cyx3705/2025-001/b-Office/电气BOM表.xlsx

Sheet: Revision History
Revision 版本 | Description 变更描述 | Date 变更日期 | Updated BY 变更人 | Remarks 备注
1.01 | 新增伺服驱动器外部电气元件表格17-23栏,文档号修改 | 2025-11-20 | 夏姜楠
1.02 | 减少断路器、滤波器、制动电阻、保险丝个数 | 2025-11-21 | 夏姜楠
1.03 | 新增1个数字输出模块和9个端子排 | 2025-11-21 | 夏姜楠

Sheet: BOM模板
 | Product Name 成品名称 |  | DOC. Number 文件编号 |  | Rev. 版本号 |  |  | Updated BY 更新人 |  | Checked BY 审核人 |  | Approved BY 批准人
 |  |  | BOM-503TWM0203 |  | 1.03 |  |  |  |  |  |  |  |  |  | T
 |  |  |  |  |  |  |  | Date 日期 |  | Date 日期 |  | Date 日期
 |  |  | Initial Date 初版日期
Item 序号 | 文档号 | Description 名称 | Specification 参数描述 | Manufacturer 制造商 |  | RoHS 有毒 元素 控制 | QTY 数量 | Unit 单位 | Substitute P/N 替代料P/N | Remarks 备注 | EPDM Auto EPDM自动导出 | Optimized 优选等级 | Unit Price 单价(RMB) | Subtotal 合计(RMB)
 |  |  |  | Model No. 型号 | Brand 品牌
1 | N2511-030Q | 小型断路器 | 220v / 6A | NXB-63H | CHT |  | 1 | 个
2 | N2511-0306 | 变压器 | 220V AC/24V DC | NDKH-40 | CHT |  | 1 | 个
3 | N2511-030R | 接线排 | 20位线15A | TD-3020 | 凯蓝制造 |  | 2 | 个
4 | N2511-0104 | 三色灯+蜂鸣器 | 24V DC | TB50-RGY-J-E-B1 | 乐清台邦 |  | 1 | 个
5 | N2511-030M | PLC | 24V DC/24V DC | AM402-CPU1608TN | INO |  | 1 | 个
6 | N2511-030S | 触摸屏 | 24V DC/24V DC | IT7070S | INO |  | 1 | 个
7 | N2511-030T | 伺服驱动器 | 220V AC/24V DC | SV605NS5R5I | INO |  | 2 | 个
8 | N2511-030N | 伺服驱动器 | 220V AC/24V DC | SV605NS2R8I | INO |  | 1 | 个
9 | N2511-030U | 安全继电器 | 24VDC | PNOZXV2 | PILZ |  | 1 | 个
10 | N2511-5100 | 伺服电机 | 220V /4.4A | MS1H1-75B30CB-A334R | INO |  | 2 | 个
11 | N2511-510A | 伺服电机 | 220V /0.6A | MS1H1-10B30CB-A330R | INO |  | 1 | 个
12 | N2511-030F | 急停按钮 | 24V DC | A22E_L_01 | OMRON |  | 1 | 个
13 | N2511-030P | 复位按钮 | 24V DC | LA16Y-11 | OHDI |  | 1 | 个
14 | N2511-5102 | 小型电机 |  |  |  |  | 2 | 个
15 | N2511-0115 |  | 6芯 | KVVR | 一佳电工 |  | 3000 | mm
16 | N2511-030X | 保险丝 | 7.9A | FWP-35C | Bussmann |  | 1 | 个
17 | N2511-031X | 保险丝 | 4A | FWP-20B | Bussmann |  | 1 | 个
18 | N2511-030Y | 滤波器 | 7.9A | FN 2090-8-06 | Schaffner |  | 1 | 个
19 | N2511-031Y | 滤波器 | 4A | FN 2090-4-06 | Schaffner |  | 1 | 个
20 | N2511-030Z | 制动电阻 | 绕线电阻器-50W-50Ω-±5%-60x22x10mm-铝壳电阻 | TRX50W±5%-BW01011-50R | 百亨 |  | 1 | 个
21 | N2511-031Z | 制动电阻 | 绕线电阻器-50W-50Ω-±5%-120x22x10mm-铝壳电阻 | TRX50W±5%-BW02002-50R | 百亨 |  | 1 | 个
22 | N2511-032X | 断路器 | 16A | OSMC32N2C16 | 施耐德 |  | 1 | 个
23 | N2511-033X | 断路器 | 6A | OSMC32N2C6 | 施耐德 |  | 1 | 个
24 |  | 集中式扩展模块 | 数字输出模块 | GL10-0016ER | 汇川 |  | 1 | 个
25 |  | 端子排 |  |  |  |  | 9 | 个
 |  |  |  |  |  |  |  |  |  |  |  |  |  | Total:
