cyx3705/2025-001/b-Office/BOM表.xlsx

Sheet: Revision History
Revision 版本 | Description 变更描述 | Date 变更日期 | Updated BY 变更人 | Remarks 备注

Sheet: BOM模板
 | Product Name 成品名称 |  | DOC. Number 文件编号 |  | Rev. 版本号 |  | Updated BY 更新人 |  | Checked BY 审核人 |  | Approved BY 批准人
 |  |  | BOM-503TWM0203 |  | 1.00 |  | 张航诚
 | N2511-XLJ |  |  |  |  |  | Date 日期 |  | Date 日期 |  | Date 日期
 |  |  | Initial Date 初版日期
Item 序号 | 文档号 | Description 名称 | Specification 参数描述 | Manufacturer 制造商 |  | QTY 数量 | Unit 单位 | Substitute P/N 替代料P/N | Remarks 备注 | EPDM Auto EPDM自动导出 | Optimized 优选等级 | Unit Price 单价(RMB) | Subtotal 合计(RMB)
 |  |  |  | Model No. 型号 | Brand 品牌
1 | N2511-0201 | 水箱 | 720*440*240 | 卧式70L | 君瑶塑业
2 | N2511-0202 | 宝塔头D
3 | N2511-0301
4 | N2511-0302
5 | N2511-0303
6 | N2511-0304
7 | N2511-0305
8 | N2511-0306
9 | N2511-0307
10 | N2511-0308
11 | N2511-0309
12 | N2511-030A
13 | N2511-030B
14 | N2511-030C
15 | N2511-030D
16 | N2511-030E
17 | N2511-030F
18 | N2511-030G
19 | N2511-030H
20 | N2511-030J
21 | N2511-030K
22 | N2511-030M
23 | N2511-030N
24 | N2511-030O
25 | N2511-0310
26 | N2511-0320
27 | N2511-0330
28 | N2511-0340
29 | N2511-0350
 | N2511-
31 | N2511-
32 | N2511-
33 | N2511-
34 | N2511-
35 | N2511-
36 | N2511-
37 | N2511-
38 | N2511-
39 | N2511-
40 | N2511-
41 | N2511-
42 | N2511-
43 | N2511-
44 | N2511-
45 | N2511-
46 | N2511-
47 | N2511-
48 | N2511-
49 | N2511-
50 | N2511-
51 | N2511-
52 | N2511-
53 | N2511-
 |  |  |  |  |  |  |  |  |  |  |  |  | Total:
