cyx3705/2025-001/b-Module-SE/4000-抬升/新建文件夹/零件1_par.stp

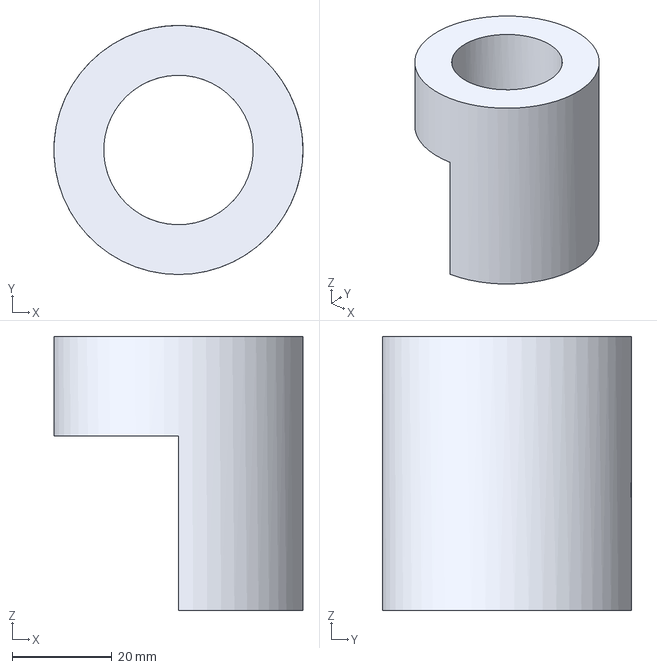
[picture p24: CAD file, 2026-09-21]
b-Module-SE/4000-抬升/新建文件夹/零件1_par.stp
50.0 x 50.0 x 55.0 mm
