cyx3705/2025-001/b-Module-SE/6000-净水/6100-净水器/净水器装配.IGS

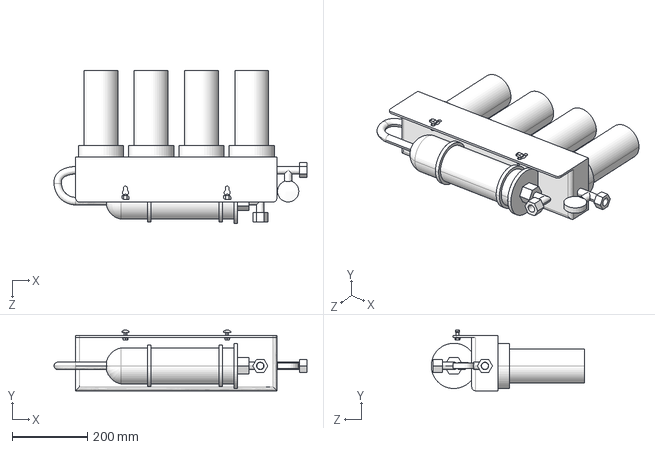
[picture p25: CAD file, 2026-09-21]
b-Module-SE/6000-净水/6100-净水器/净水器装配.IGS
671.7 x 160.7 x 407.5 mm
