cyx3705/2025-001/(list of files, cad)

Other CAD files:
b-Module-SW/0-装配体.SLDASM
b-Module-2D/工程图.dwg
b-Module-SW/零件.SLDPRT
b-Module-SE/4000-抬升/新建文件夹/_model1.prt
b-Module-SE/4000-抬升/新建文件夹/零件1_par.prt
