cyx3705/2025-001/b-Module-2D/3300-背板装配（含水槽出口）.pdf

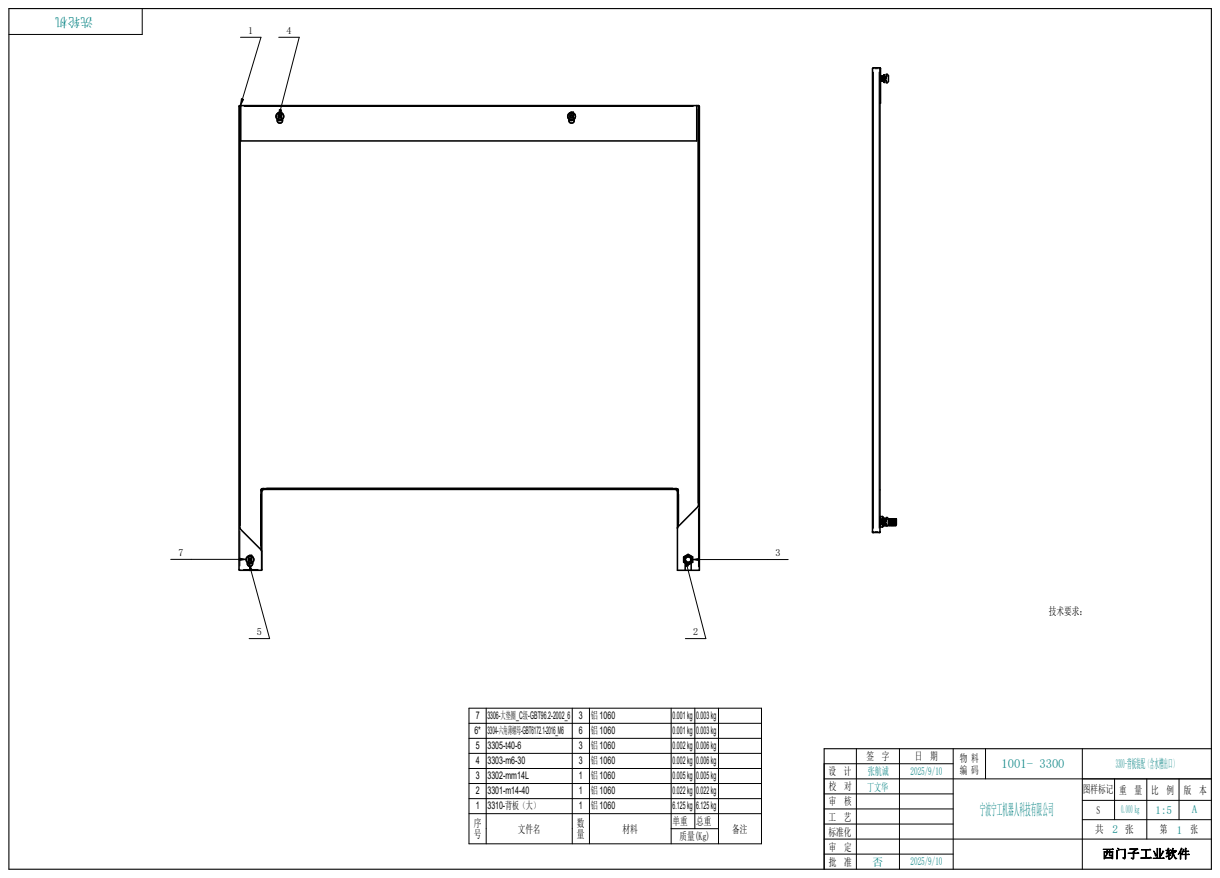
[picture p26: page 1]
技术要求：; 文件名

7 | 3306-_C -GBT96.2- 大大大 级 2002_6 | 3 | 铝 1060 | 0.001 kg 0.003 kg
6* | 3304--GBT6172.1- 六六六六六 2016_M6 | 6 | 铝 1060 | 0.001 kg 0.003 kg
5 | 3305-t40-6 | 3 | 铝 1060 | 0.002 kg 0.006 kg
4 | 3303-m6-30 | 3 | 铝 1060 | 0.002 kg 0.006 kg
3 | 3302-mm14L | 1 | 铝 1060 | 0.005 kg
2 | 3301-m14-40 | 1 | 铝 1060 | 0.022 kg
1 | 3310-背板（大） | 1 | 铝 1060 | 6.125 kg

签 字 | 日 期 | 物 料 编 码 | 1001- 3300 | 3300-背板装配（含水槽出口）
设 计 | 张航诚 | 2025/9/10

校 对 | 丁文华 | | 宁波宁工机器人科技有限公司 | 图样标记 | 重 量 | 比 例 1:5 审 核 | 版 本

工 艺
标准化
审 定 | | | 西门子工业软件
批 准 | 否 | 2025/9/10
