cyx3705/2025-001/b-Module-2D/7100-三色灯装配.pdf

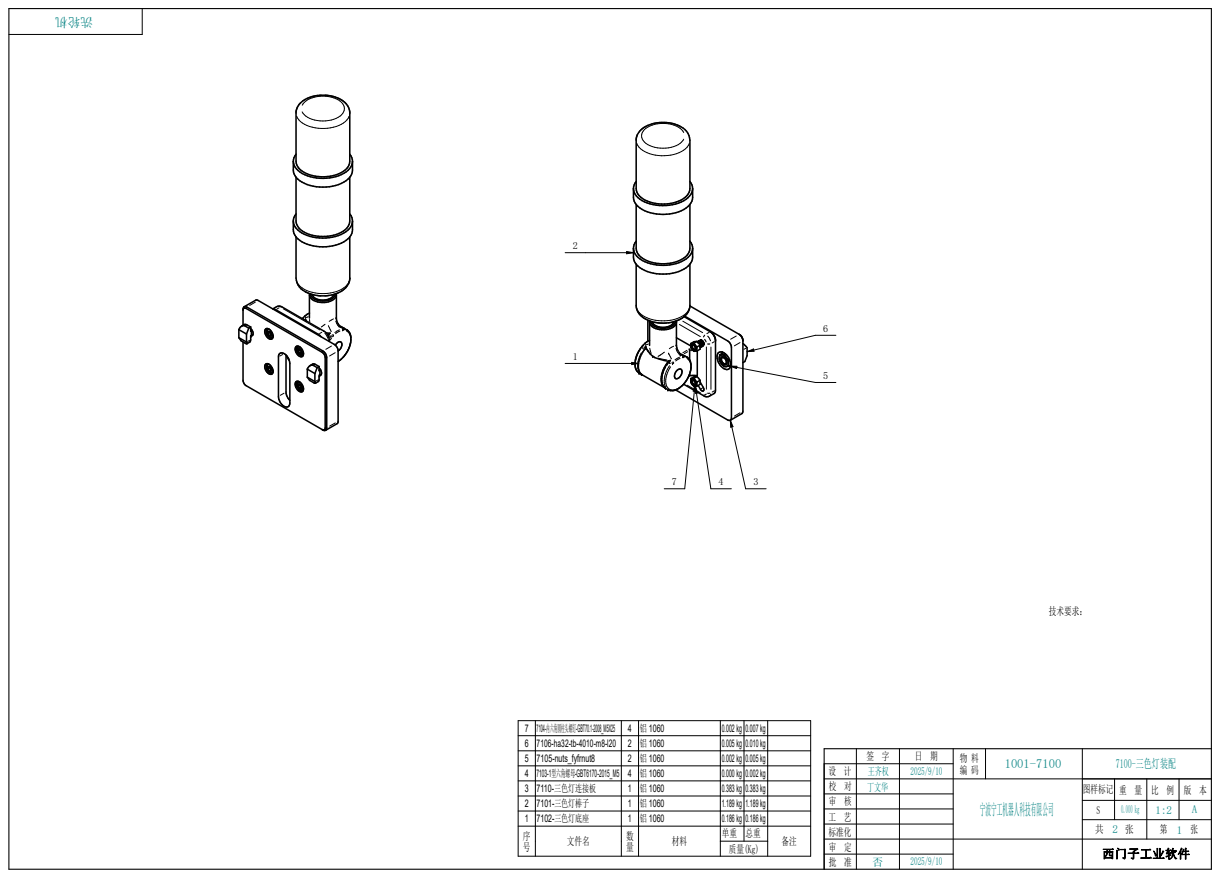
[picture p27: page 1]
7100-三色灯装配; 王齐权; 技术要求：; 7105-nuts_fyfrnut8; 文件名

7 | 7104--GBT70.1- 内内内内内内内内 2008_M5X25 | 4 | 铝 1060 | 0.002 kg 0.007 kg
6 | 7106-ha32-tb-4010-m8-l20 | 2 | 铝 1060 | 0.005 kg 0.010 kg

4 | 7103-1 -GBT 型内内内型 6170-2015_M5 | 4 | 铝 1060 | 0.000 kg 0.002 kg
3 | 7110-三色灯三三三 | 1 | 铝 1060 | 0.383 kg
2 | 7101-三色灯三子 | 1 | 铝 1060 | 1.189 kg
1 | 7102-三色灯三三 | 1 | 铝 1060 | 0.186 kg

校 对 | 丁文华 | 宁波宁工机器人科技有限公司 | 图样标记 | 重 量 | 比 例 1:2 审 核 | 版 本

工 艺
标准化
审 定 | | | 西门子工业软件
批 准 | 否 | 2025/9/10
