cyx3705/2025-001/b-Module-2D/0300-电箱-A3.pdf

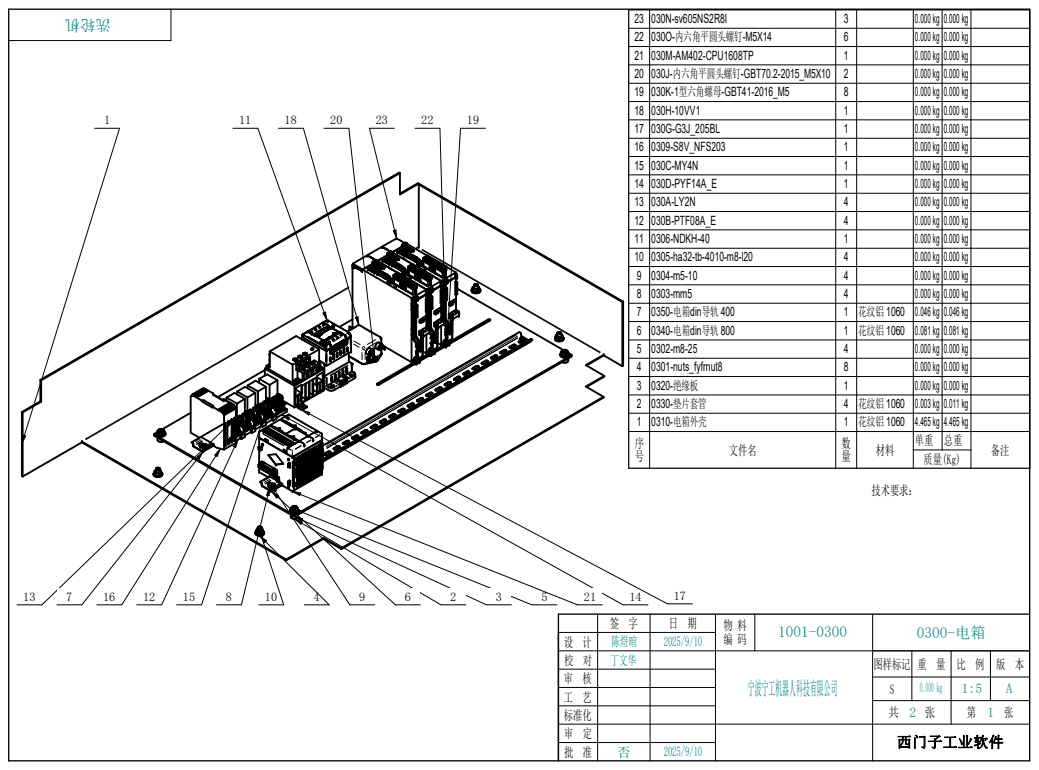
[picture p28: page 1]
技术要求：; -M5X14 内内内内内内内内; 21 030M-AM402-CPU1608TP; -GBT70.2- 内内内内内内内内; -GBT41-2 型内内内型; 16 0309-S8V_NFS203; 14 030D-PYF14A_E; 12 030B-PTF08A_E; 11 0306-NDKH-40; 7 0350- din; 1 花花花 1060 0.046 kg 0.046 kg; 6 0340- din; 1 花花花 1060 0.081 kg 0.081 kg; 4 0301-nuts_fyfrnut8; 3 0320-绝绝绝; 2 0330-垫垫垫垫; 1 0310-电箱电电; 1 花花花 1060 4.465 kg 4.465 kg; 文件名

4 花花花 1060 0.003 kg 0.011 kg

陈煜暄 | 2025/9/10

校 对 | 丁文华 | | 宁波宁工机器人科技有限公司 | 图样标记 | 重 量 | 比 例 1:5 审 核 | 版 本

工 艺
标准化
审 定 | 否 | 2025/9/10 | 西门子工业软件
批 准
