cyx3705/2025-001/b-Module-2D/0310-电箱外壳-A3.pdf

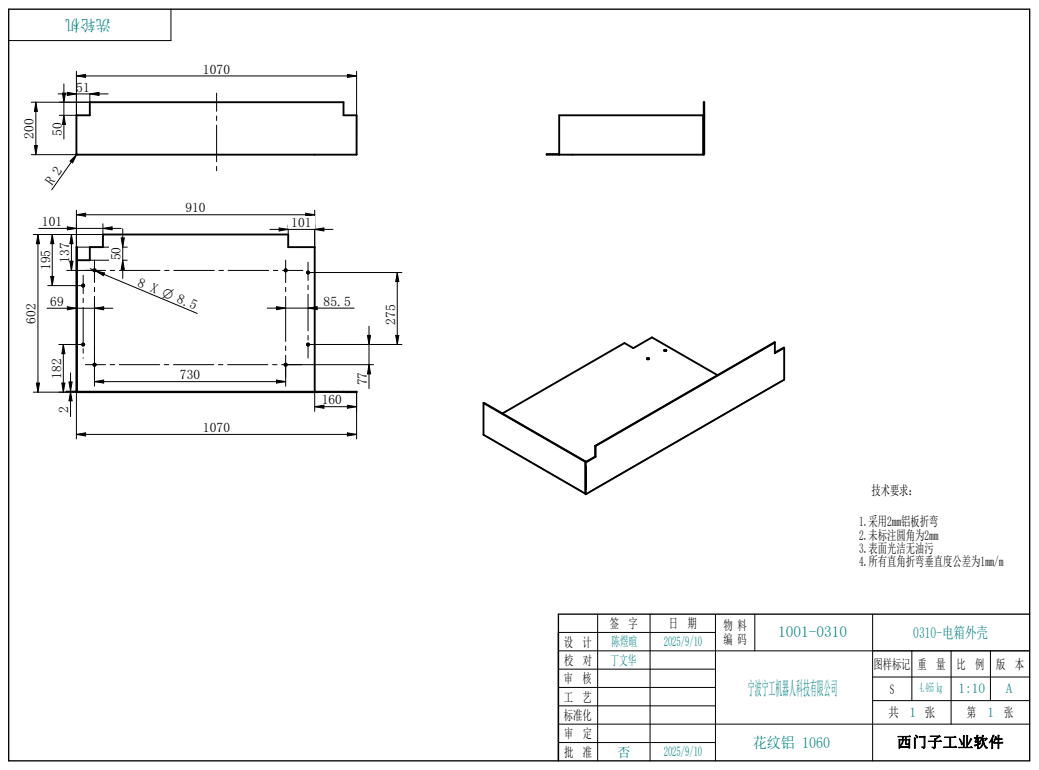
[picture p29: page 1]
技术要求：; 1.采用2mm铝板折弯 2.未标注圆角为2mm 3.表面光洁无油污 4.所有直角折弯垂直度公差为1mm/m

设 计 | 签 字 | 日 期 | 物 料 编 码 | 1001-0310 | 0310-电箱外壳

陈煜暄 | 2025/9/10

校 对 | 丁文华 | | 宁波宁工机器人科技有限公司 | 图样标记 | 重 量 | 比 例 1:10 审 核 | 版 本

S | 4.465 kg | | A
共 1 张 | | 第 1 张

工 艺
标准化
审 定 | 否 | 2025/9/10 | 花纹铝 1060 | 西门子工业软件
批 准
