cyx3705/2025-001/b-Module-2D/0330-垫片套管.pdf

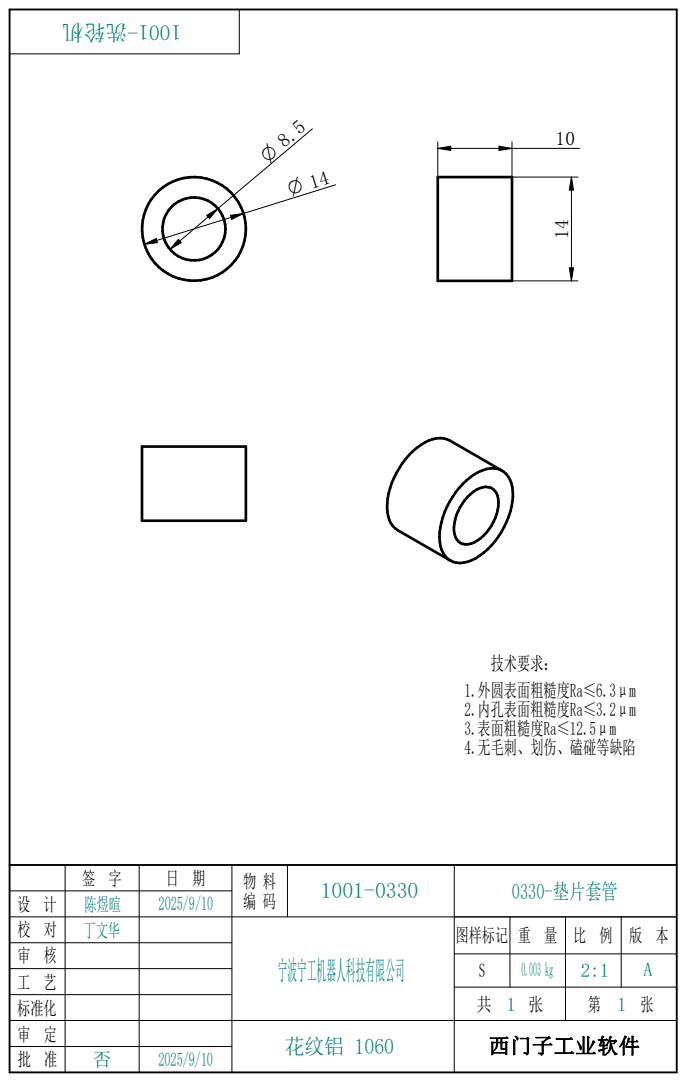
[picture p30: page 1]
技术要求：; 1.外圆表面粗糙度Ra≤6.3μm 2.内孔表面粗糙度Ra≤3.2μm 3.表面粗糙度Ra≤12.5μm 4.无毛刺、划伤、磕碰等缺陷

设 计 | 签 字 | 日 期 | 物 料 编 码 | 1001-0330 | 0330-垫片套管

陈煜暄 | 2025/9/10

校 对 | 丁文华 | | 宁波宁工机器人科技有限公司 | 图样标记 | 重 量 | 比 例 2:1 审 核 | 版 本

S | 0.003 kg | | A
共 1 张 | | 第 1 张

工 艺
标准化
审 定 | 否 | 2025/9/10 | 花纹铝 1060 | 西门子工业软件
批 准
