cyx3705/2025-001/b-Module-2D/0400-传感器.pdf

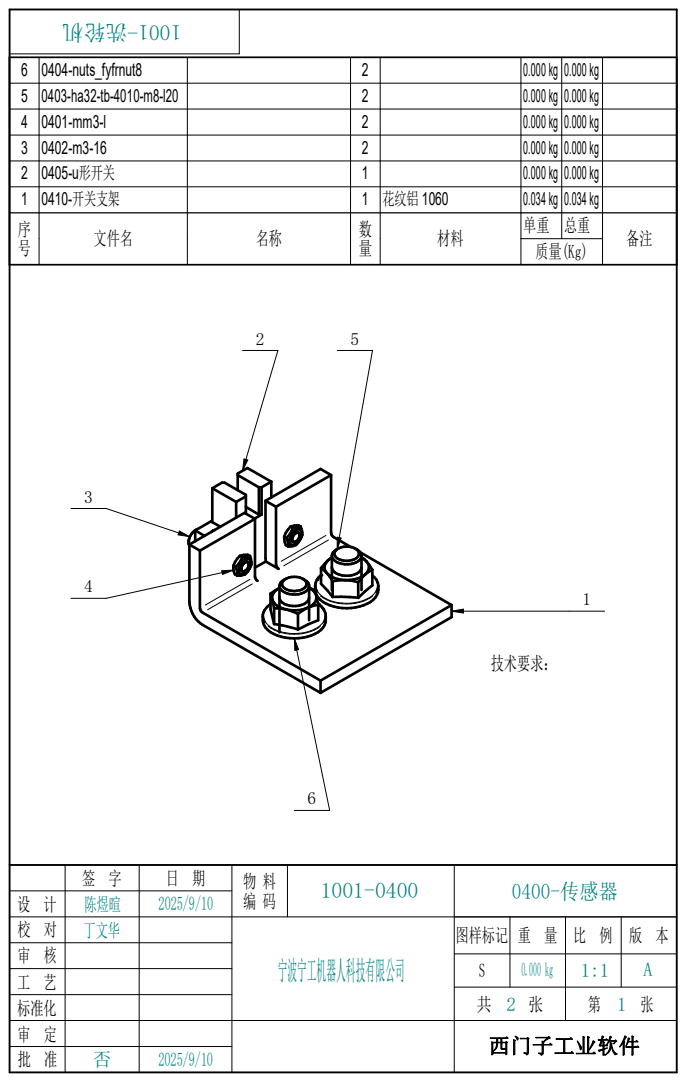
[picture p33: page 1]
技术要求：

6 | 0404-nuts_fyfrnut8 | | 2 | | 0.000 kg
5 | 0403-ha32-tb-4010-m8-l20 | | 2 | | 0.000 kg
4 | 0401-mm3-l | | 2 | | 0.000 kg
3 | 0402-m3-16 | | 2 | | 0.000 kg
2 | 0405-u形形形 | | 1 | | 0.000 kg
1 | 0410-形形开开 | | 1 | 花花花 1060 | 0.034 kg
序 号 | 文件名 | 名称 | 数

设 计 | 签 字 | 日 期 | 物 料 编 码 | 1001-0400 | 0400-传感器

陈煜暄 | 2025/9/10

校 对 | 丁文华 | | 宁波宁工机器人科技有限公司 | 图样标记 | 重 量 | 比 例 1:1 审 核 | 版 本

工 艺
标准化
审 定 | 否 | 2025/9/10 | 西门子工业软件
批 准
