cyx3705/2025-001/b-Module-2D/0410-开关支架.pdf

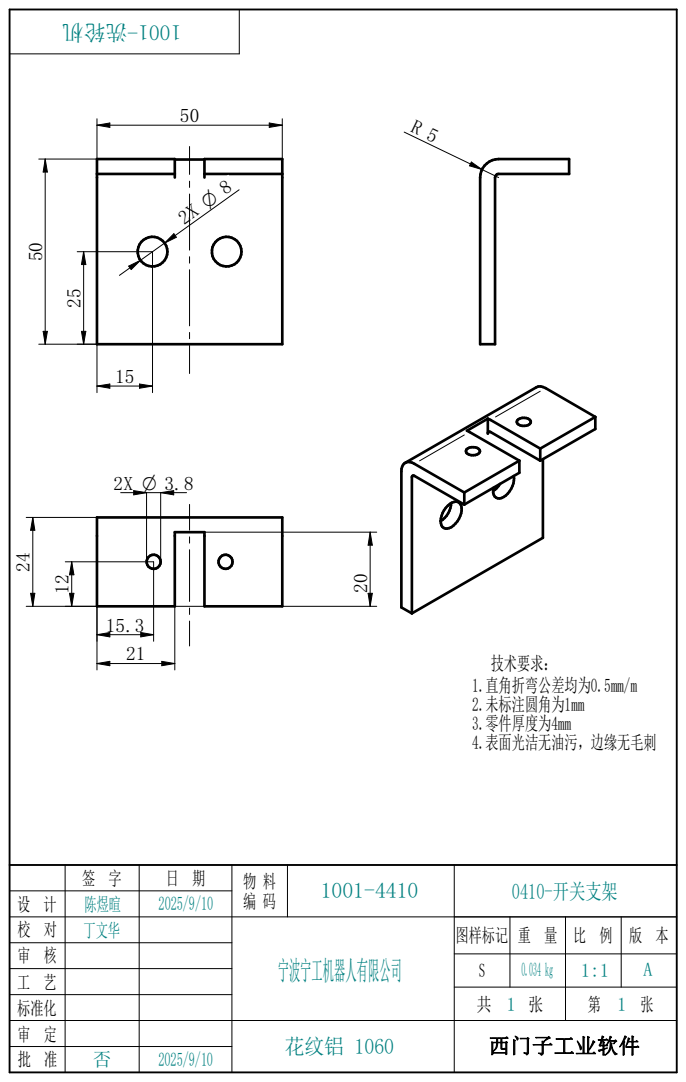
[picture p34: page 1]
技术要求：; 1.直角折弯公差均为0.5mm/m 2.未标注圆角为1mm 3.零件厚度为4mm 4.表面光洁无油污，边缘无毛刺

设 计 | 签 字 | 日 期 | 物 料 编 码 | 1001-4410 | 0410-开关支架

陈煜暄 | 2025/9/10

校 对 | 丁文华 | | 宁波宁工机器人有限公司 | 图样标记 | 重 量 | 比 例 1:1 审 核 | 版 本

S | 0.034 kg | | A
共 1 张 | | 第 1 张

工 艺
标准化
审 定 | 否 | 2025/9/10 | 花纹铝 1060 | 西门子工业软件
批 准
