cyx3705/2025-001/b-Module-2D/0500-水泵.pdf

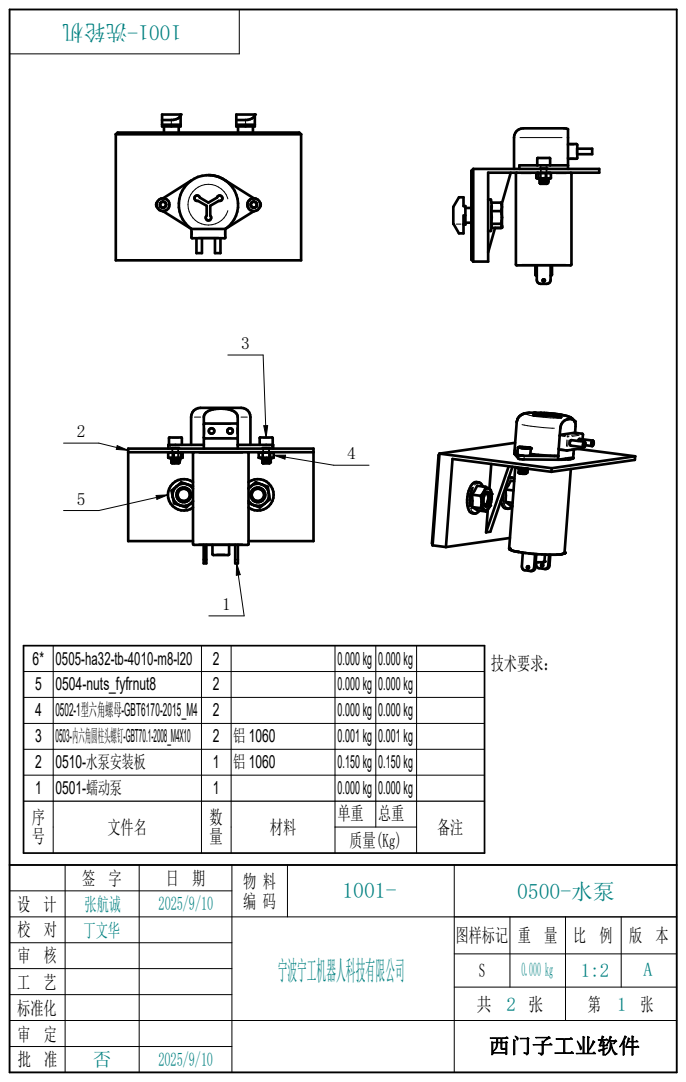
[picture p35: page 1]
技术要求：

6* | 0505-ha32-tb-4010-m8-l20 | 2 | | 0.000 kg
5 | 0504-nuts_fyfrnut8 | 2 | | 0.000 kg
4 | 0502-1 -GBT 型型型型型 6170-2015_M4 | 2 | | 0.000 kg
3 | 0503--GBT70.1- 内型型内内内型内 2008_M4X10 | 2 | 铝 1060 | 0.001 kg
2 | 0510-水泵水水水 | 1 | 铝 1060 | 0.150 kg
1 | 0501-蠕蠕泵 | 1 | | 0.000 kg
序 号 | 文件名 | 数

张航诚 | 2025/9/10

校 对 | 丁文华 | | 宁波宁工机器人科技有限公司 | 图样标记 | 重 量 | 比 例 1:2 审 核 | 版 本

工 艺
标准化
审 定 | 否 | 2025/9/10 | 西门子工业软件
批 准
