cyx3705/2025-001/b-Module-2D/0510-水泵安装板.pdf

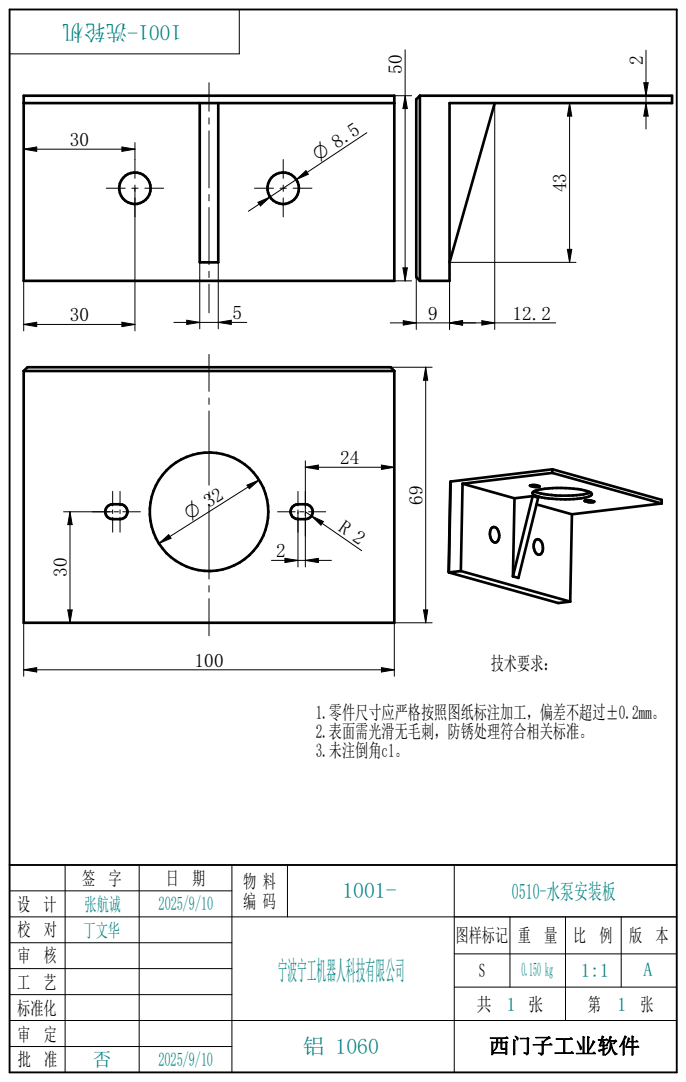
[picture p36: page 1]
技术要求：; 1.零件尺寸应严格按照图纸标注加工，偏差不超过±0.2mm。 2.表面需光滑无毛刺，防锈处理符合相关标准。 3.未注倒角c1。

设 计 | 签 字 | 日 期 | 物 料 编 码 | 1001- | 0510-水泵安装板

张航诚 | 2025/9/10

校 对 | 丁文华 | | 宁波宁工机器人科技有限公司 | 图样标记 | 重 量 | 比 例 1:1 审 核 | 版 本

S | 0.150 kg | | A
共 1 张 | | 第 1 张

工 艺
标准化
审 定 | 否 | 2025/9/10 | 铝 1060 | 西门子工业软件
批 准
