cyx3705/2025-001/b-Module-2D/0700-水盆-A3.pdf

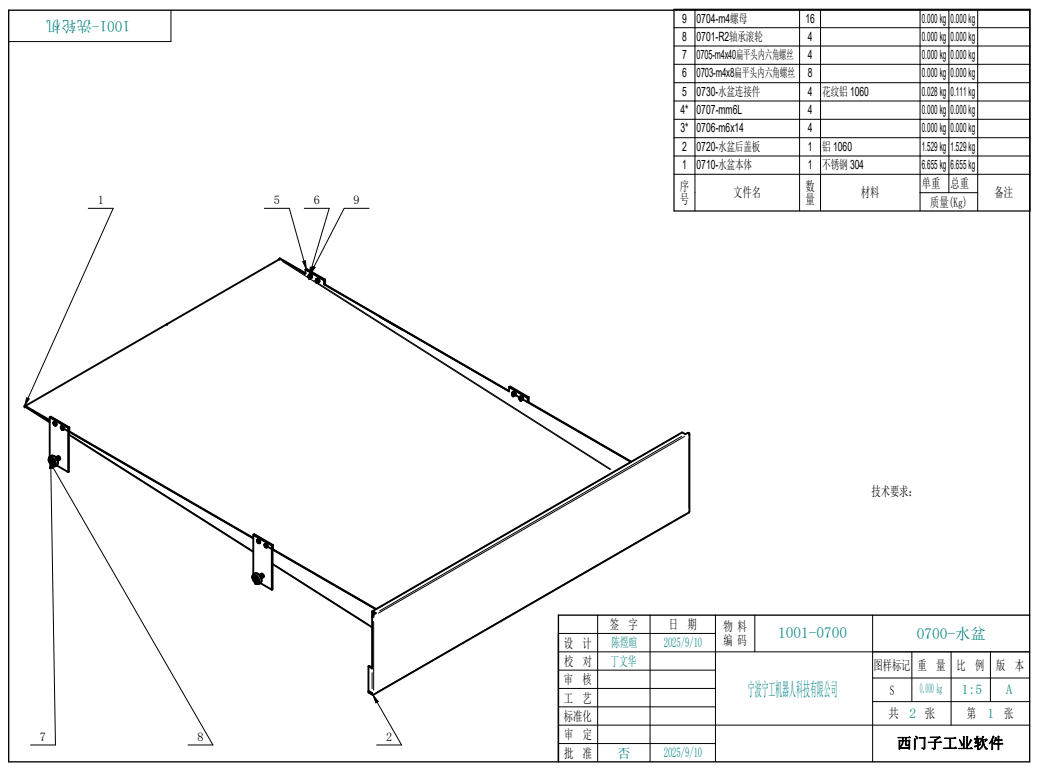
[picture p37: page 1]
技术要求：; 文件名

9 | 0704-m4螺螺 | 16 | | 0.000 kg
8 | 0701-R2轴轴轴轮 | 4 | | 0.000 kg
7 | 0705-m4x40扁扁扁扁扁扁螺扁 | 4 | | 0.000 kg
6 | 0703-m4x8扁扁扁扁扁扁螺扁 | 8 | | 0.000 kg
5 | 0730-水盆水水件 | 4 | 花花花 1060 | 0.028 kg 0.111 kg
4* | 0707-mm6L | 4 | | 0.000 kg
3* | 0706-m6x14 | 4 | | 0.000 kg
2 | 0720-水盆水水水 | 1 | 花 1060 | 1.529 kg
1 | 0710-水盆本水 | 1 | 不不不 304 | 6.655 kg

陈煜暄 | 2025/9/10

校 对 | 丁文华 | | 宁波宁工机器人科技有限公司 | 图样标记 | 重 量 | 比 例 1:5 审 核 | 版 本

工 艺
标准化
审 定 | 否 | 2025/9/10 | 西门子工业软件
批 准
