cyx3705/2025-001/b-Module-2D/0710-水盆本体.pdf

I

A

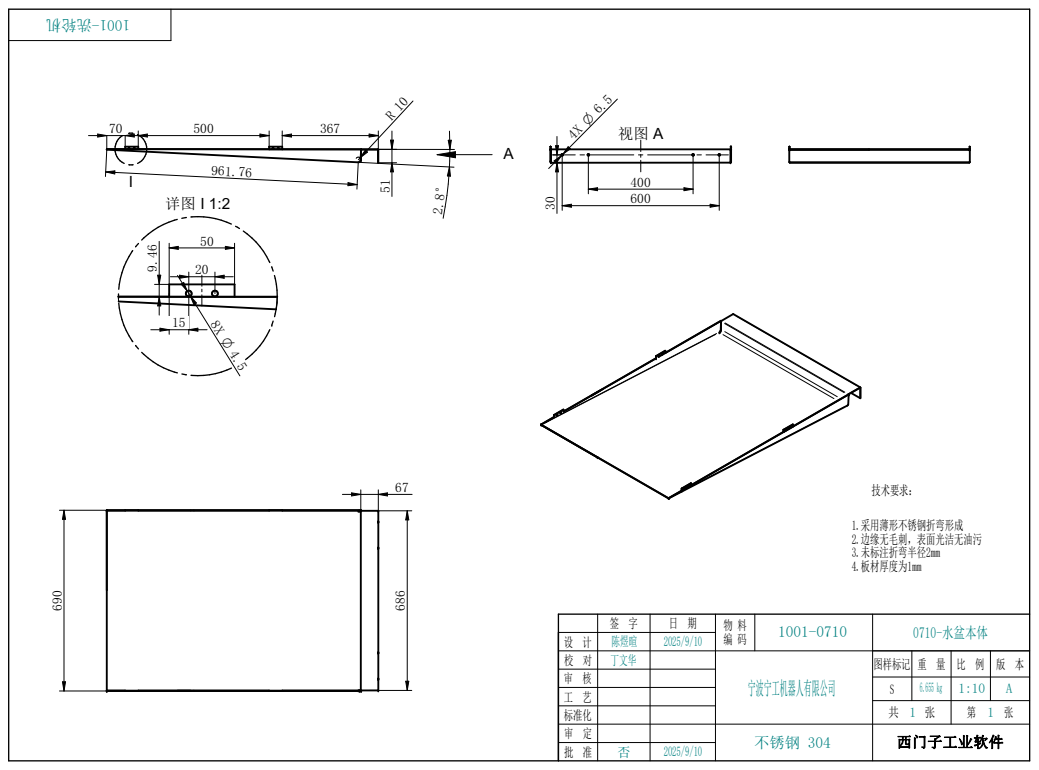
[picture p38: page 1]
技术要求：; 1.采用薄形不锈钢折弯形成 2.边缘无毛刺，表面光洁无油污 3.未标注折弯半径2mm 4.板材厚度为1mm

设 计 | 签 字 | 日 期 | 物 料 编 码 | 1001-0710 | 0710-水盆本体

陈煜暄 | 2025/9/10

校 对 | 丁文华 | | 宁波宁工机器人有限公司 | 图样标记 | 重 量 | 比 例 1:10 审 核 | 版 本

S | 6.655 kg | | A
共 1 张 | | 第 1 张

工 艺
标准化
审 定 | 否 | 2025/9/10 | 不锈钢 304 | 西门子工业软件
批 准
