cyx3705/2025-001/b-Module-2D/0730-水盆连接件.pdf

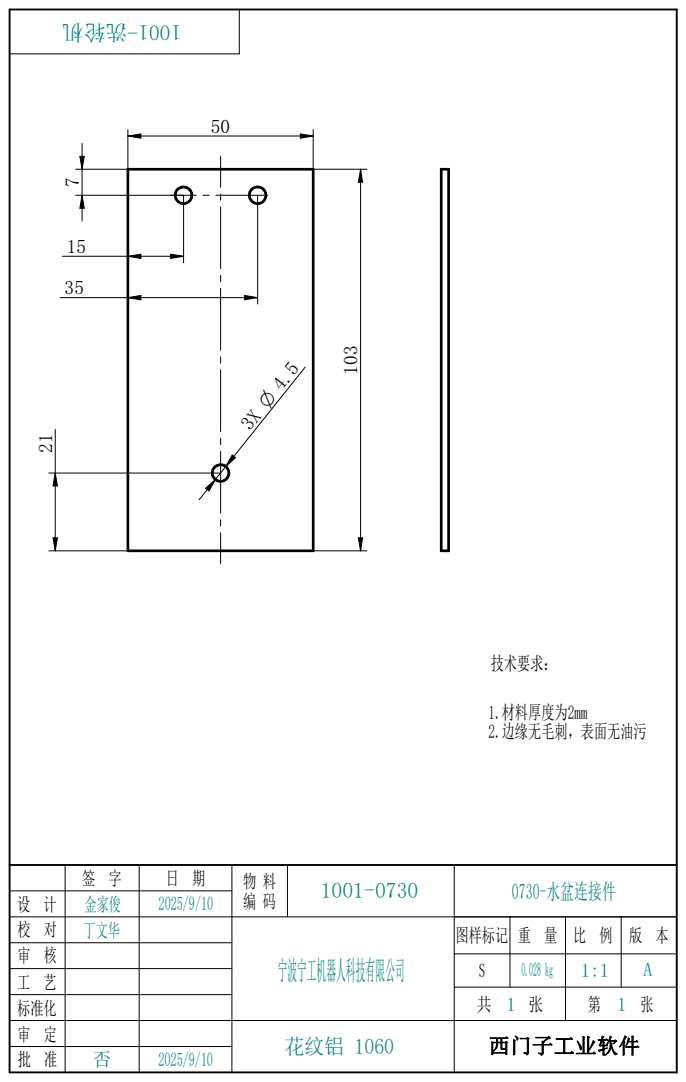
[picture p40: page 1]
技术要求：; 1.材料厚度为2mm 2.边缘无毛刺，表面无油污

设 计 | 签 字 | 日 期 | 物 料 编 码 | 1001-0730 | 0730-水盆连接件

金家俊 | 2025/9/10

校 对 | 丁文华 | | 宁波宁工机器人科技有限公司 | 图样标记 | 重 量 | 比 例 1:1 审 核 | 版 本

S | 0.028 kg | | A
共 1 张 | | 第 1 张

工 艺
标准化
审 定 | 否 | 2025/9/10 | 花纹铝 1060 | 西门子工业软件
批 准
