cyx3705/2025-001/b-Module-2D/0800-连接口.pdf

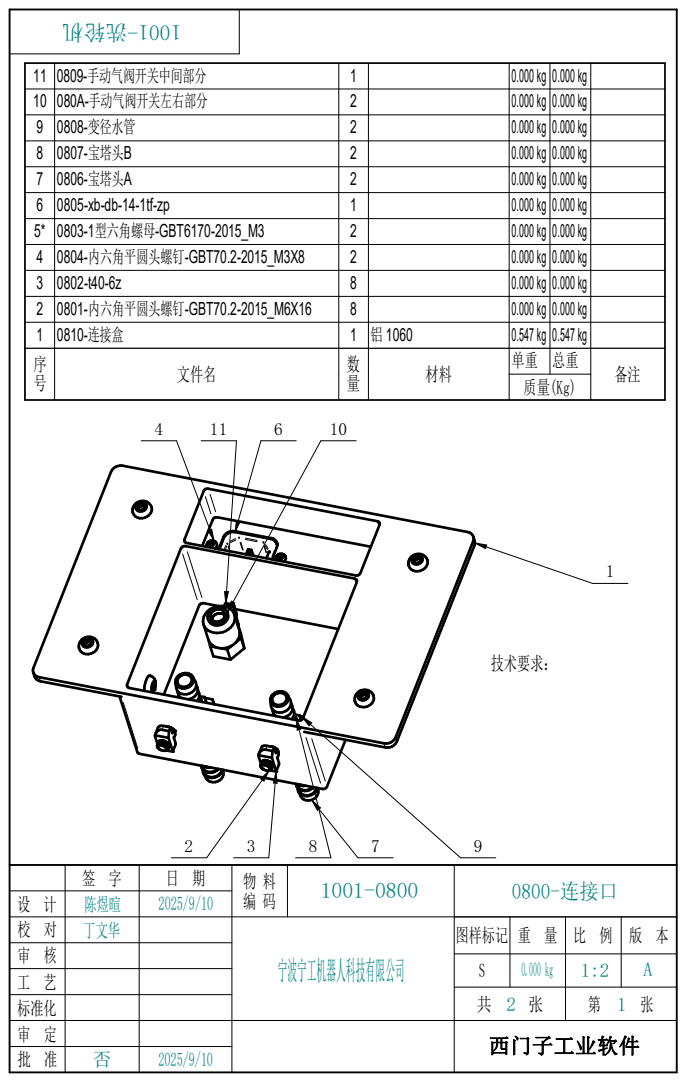
[picture p41: page 1]
技术要求：

11 | 0809-手手手手手手手手手手 | 1 | | 0.000 kg
10 | 080A-手手手手手手手手手手 | 2 | | 0.000 kg
9 | 0808-变变变变 | 2 | | 0.000 kg
8 | 0807-B 宝宝宝 | 2 | | 0.000 kg
7 | 0806-A 宝宝宝 | 2 | | 0.000 kg
6 | 0805-xb-db-14-1tf-zp | 1 | | 0.000 kg
5* | 0803-1 -GBT6170- 型型型型型 2015_M3 | 2 | | 0.000 kg
4 | 0804--GBT70.2- 内型型内内宝型内 2015_M3X8 | 2 | | 0.000 kg
3 | 0802-t40-6z | 8 | | 0.000 kg
2 | 0801--GBT70.2- 内型型内内宝型内 2015_M6X16 | 8 | | 0.000 kg
1 | 0810-连接连 | 1 | 铝 1060 | 0.547 kg
序 号 | 文件名 | 数

设 计 | 签 字 | 日 期 | 物 料 编 码 | 1001-0800 | 0800-连接口

陈煜暄 | 2025/9/10

校 对 | 丁文华 | | 宁波宁工机器人科技有限公司 | 图样标记 | 重 量 | 比 例 1:2 审 核 | 版 本

工 艺
标准化
审 定 | 否 | 2025/9/10 | 西门子工业软件
批 准
