cyx3705/2025-001/b-Module-2D/0810-连接盒-A3.pdf

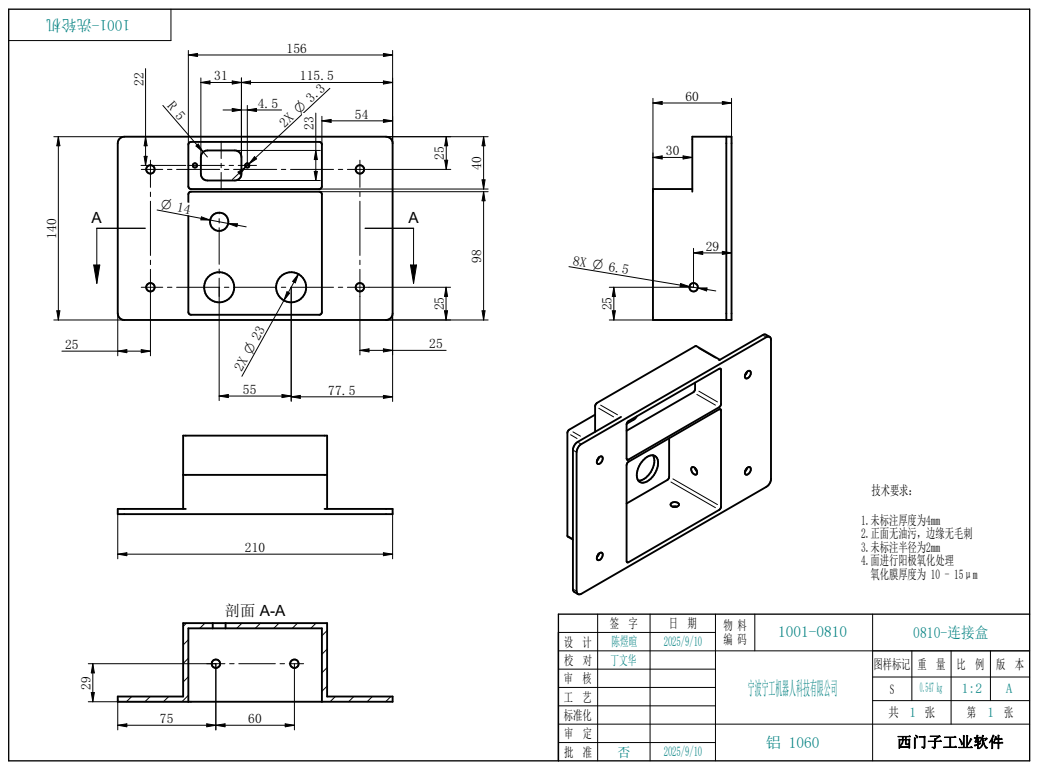
[picture p42: page 1]
技术要求：; 1.未标注厚度为4mm 2.正剖无油污，边缘无毛刺 3.未标注半径为2mm 4.剖进行阳极氧化处理 氧化膜厚度为 10 - 15μm

设 计 | 签 字 | 日 期 | 物 料 编 码 | 1001-0810 | 0810-连接盒

陈煜暄 | 2025/9/10

校 对 | 丁文华 | | 宁波宁工机器人科技有限公司 | 图样标记 | 重 量 | 比 例 1:2 审 核 | 版 本

S | 0.547 kg | | A
共 1 张 | | 第 1 张

工 艺
标准化
审 定 | 否 | 2025/9/10 | 铝 1060 | 西门子工业软件
批 准
