cyx3705/2025-001/b-Module-2D/1000-框架.pdf

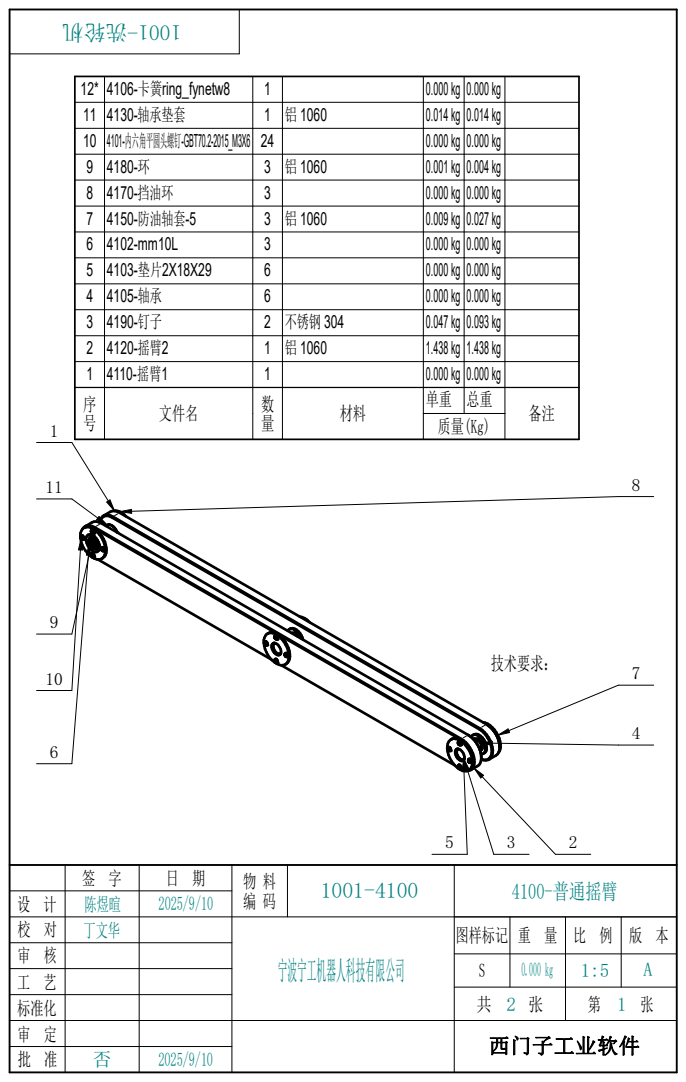
[picture p43: page 1]
技术要求：

12* | 4106- ring_fynetw8 卡卡 | 1 | | 0.000 kg
11 | 4130-轴轴轴轴 | 1 | 铝 1060 | 0.014 kg
10 | 4101--GBT70.2- 内内内内内内内内 2015_M3X6 | 24 | | 0.000 kg
9 | 4180-环 | 3 | 铝 1060 | 0.001 kg 0.004 kg
8 | 4170-挡挡环 | 3 | | 0.000 kg
7 | 4150--5 防挡轴轴 | 3 | 铝 1060 | 0.009 kg 0.027 kg
6 | 4102-mm10L | 3 | | 0.000 kg
5 | 4103- 2X18X29 轴垫 | 6 | | 0.000 kg
4 | 4105-轴轴 | 6 | | 0.000 kg
3 | 4190-内子 | 2 | 不不不 304 | 0.047 kg 0.093 kg
2 | 4120- 2 摇臂 | 1 | 铝 1060 | 1.438 kg
1 | 4110-1 摇臂 | 1 | | 0.000 kg
序 号 | 文件名 | 数

设 计 | 签 字 | 日 期 | 物 料 编 码 | 1001-4100 | 4100-普通摇臂

陈煜暄 | 2025/9/10

校 对 | 丁文华 | | 宁波宁工机器人科技有限公司 | 图样标记 | 重 量 | 比 例 1:5 审 核 | 版 本

工 艺
标准化
审 定 | 否 | 2025/9/10 | 西门子工业软件
批 准
