cyx3705/2025-001/b-Module-2D/1200-连接件.pdf

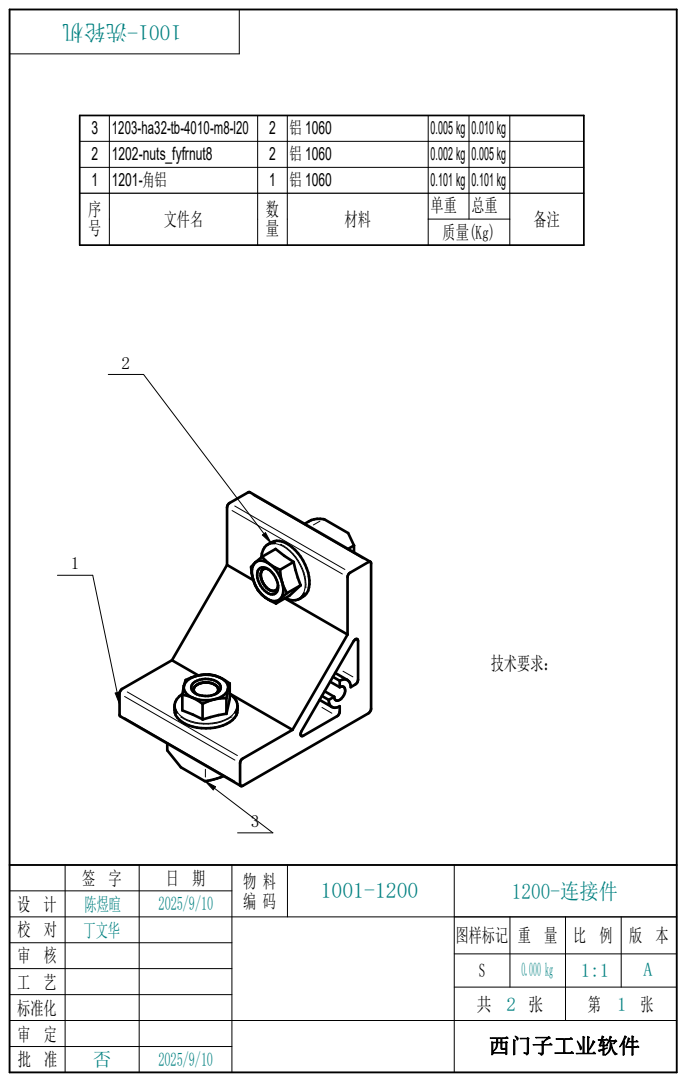
[picture p44: page 1]
技术要求：

3 | 1203-ha32-tb-4010-m8-l20 | 2 | 铝 1060 | 0.005 kg 0.010 kg
2 | 1202-nuts_fyfrnut8 | 2 | 铝 1060 | 0.002 kg 0.005 kg
1 | 1201-角铝 | 1 | 铝 1060 | 0.101 kg
序 号 | 文件名 | 数

设 计 | 签 字 | 日 期 | 物 料 编 码 | 1001-1200 | 1200-连接件

陈煜暄 | 2025/9/10

校 对 | 丁文华 | | | 图样标记 | 重 量 | 比 例 1:1 审 核 | 版 本

S | 0.000 kg | | A
共 2 张 | | 第 1 张

工 艺
标准化
审 定 | 否 | 2025/9/10 | 西门子工业软件
批 准
