cyx3705/2025-001/b-Module-2D/1600-隔板c.pdf

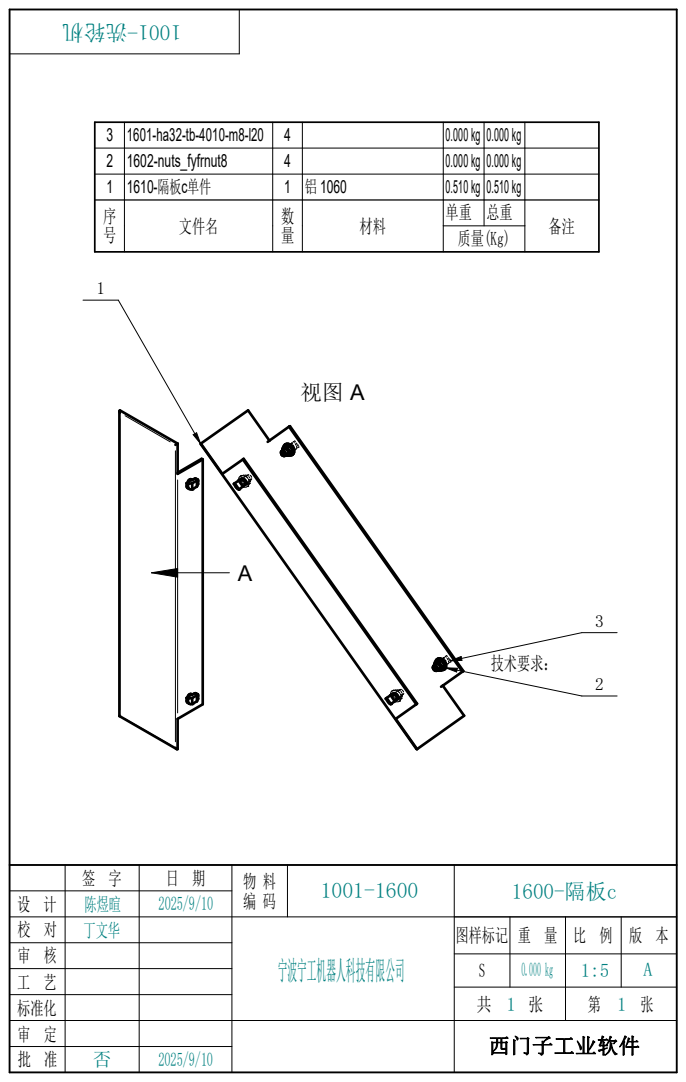
[picture p47: page 1]
技术要求：

3 | 1601-ha32-tb-4010-m8-l20 | 4 | | 0.000 kg
2 | 1602-nuts_fyfrnut8 | 4 | | 0.000 kg
1 | 1610- c 隔板 单件 | 1 | 铝 1060 | 0.510 kg
序 号 | 文件名 | 数

设 计 | 签 字 | 日 期 | 物 料 编 码 | 1001-1600 | 1600-隔板c

陈煜暄 | 2025/9/10

校 对 | 丁文华 | | 宁波宁工机器人科技有限公司 | 图样标记 | 重 量 | 比 例 1:5 审 核 | 版 本

工 艺
标准化
审 定 | 否 | 2025/9/10 | 西门子工业软件
批 准
