cyx3705/2025-001/b-Module-2D/1810-隔板e单件.pdf

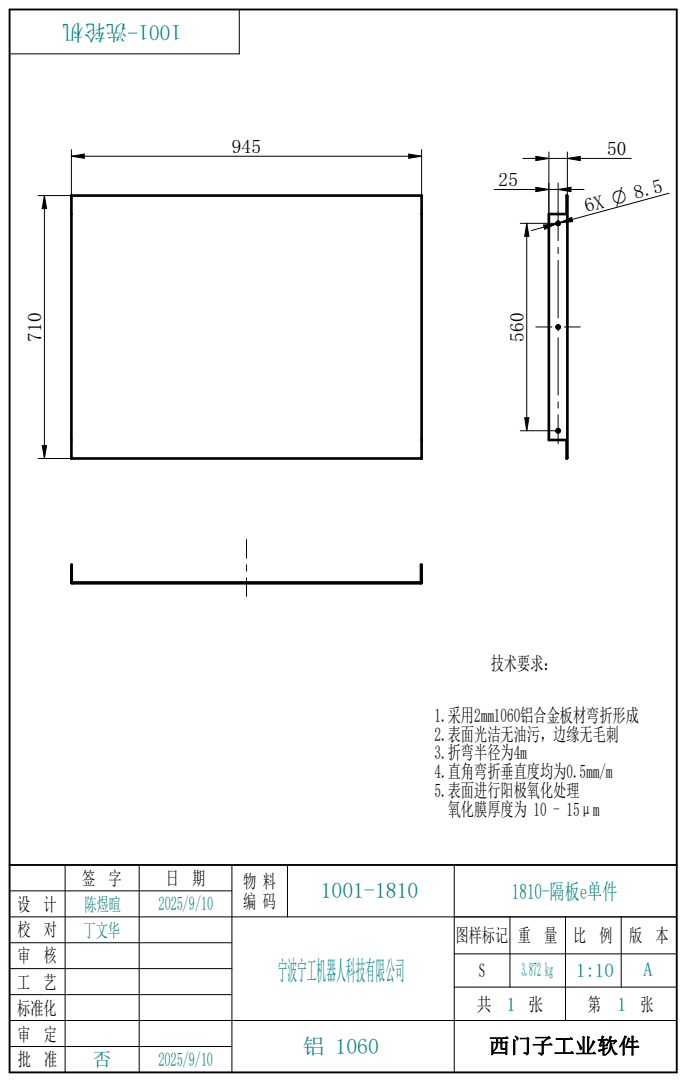
[picture p50: page 1]
技术要求：; 1.采用2mm1060铝合金板材弯折形成 2.表面光洁无油污，边缘无毛刺 3.折弯半径为4m 4.直角弯折垂直度均为0.5mm/m 5.表面进行阳极氧化处理 氧化膜厚度为 10 - 15μm

设 计 | 签 字 | 日 期 | 物 料 编 码 | 1001-1810 | 1810-隔板e单件

陈煜暄 | 2025/9/10

校 对 | 丁文华 | | 宁波宁工机器人科技有限公司 | 图样标记 | 重 量 | 比 例 1:10 审 核 | 版 本

S | 3.872 kg | | A
共 1 张 | | 第 1 张

工 艺
标准化
审 定 | 否 | 2025/9/10 | 铝 1060 | 西门子工业软件
批 准
