cyx3705/2025-001/b-Module-2D/2200-固定环2.pdf

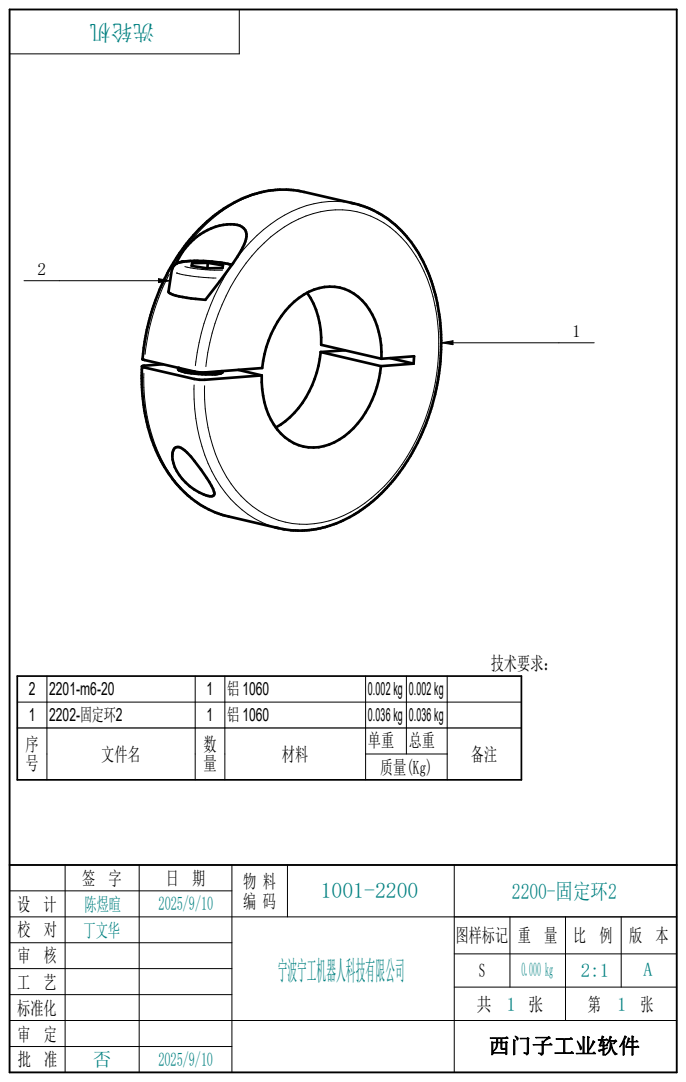
[picture p52: page 1]
技术要求：

2 | 2201-m6-20 | 1 | 铝 1060 | 0.002 kg
1 | 2202-2 固定环 | 1 | 铝 1060 | 0.036 kg
序 号 | 文件名 | 数

设 计 | 签 字 | 日 期 | 物 料 编 码 | 1001-2200 | 2200-固定环2

陈煜暄 | 2025/9/10

校 对 | 丁文华 | | 宁波宁工机器人科技有限公司 | 图样标记 | 重 量 | 比 例 2:1 审 核 | 版 本

工 艺
标准化
审 定 | 否 | 2025/9/10 | 西门子工业软件
批 准
