cyx3705/2025-001/b-Module-2D/2300-前传动轴.pdf

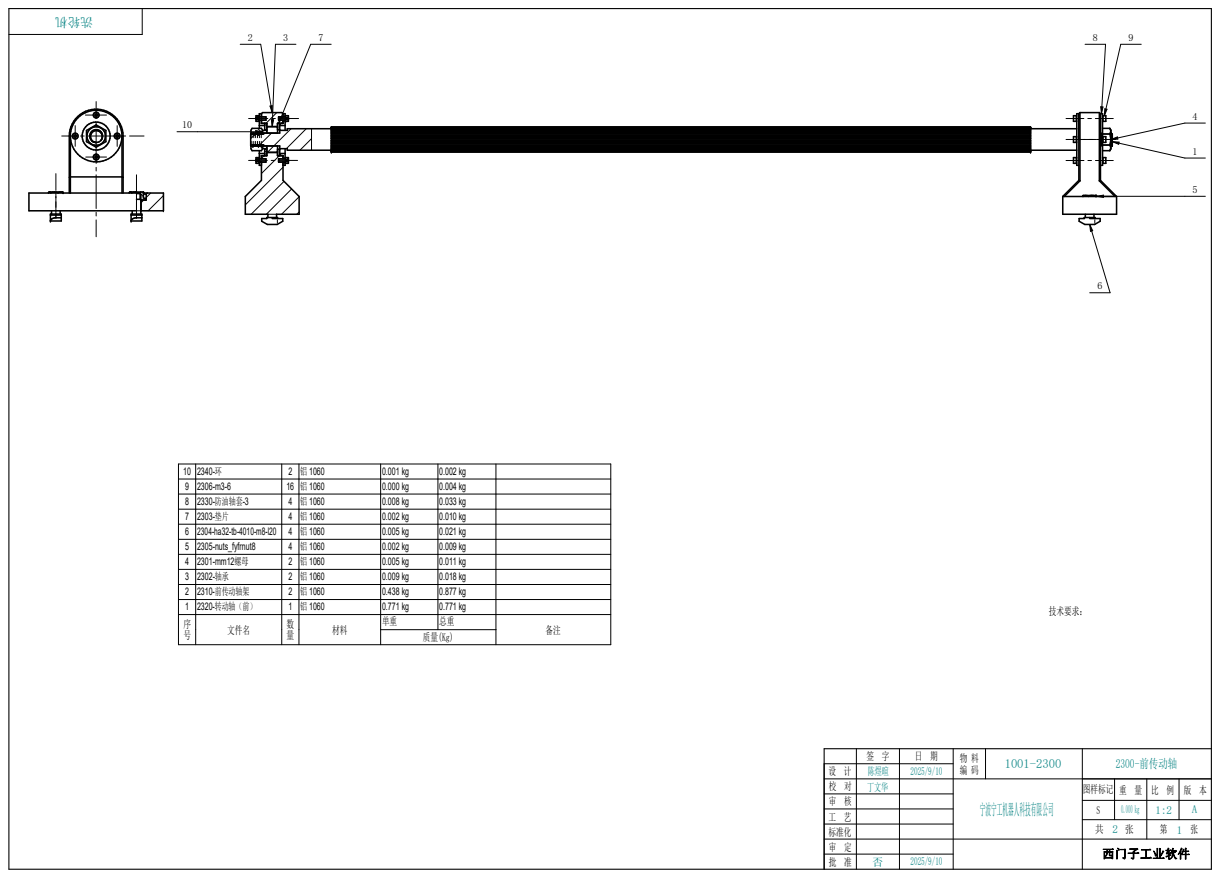
[picture p53: page 1]
技术要求：; 文件名

10 | 2340-环 | 2 | 铝 1060 | 0.001 kg | 0.002 kg
9 | 2306-m3-6 | 16 | 铝 1060 | 0.000 kg | 0.004 kg
8 | 2330--3 防防轴防 | 4 | 铝 1060 | 0.008 kg | 0.033 kg
7 | 2303-垫垫 | 4 | 铝 1060 | 0.002 kg | 0.010 kg
6 | 2304-ha32-tb-4010-m8-l20 | 4 | 铝 1060 | 0.005 kg | 0.021 kg
5 | 2305-nuts_fyfrnut8 | 4 | 铝 1060 | 0.002 kg | 0.009 kg
4 | 2301-mm12螺螺 | 2 | 铝 1060 | 0.005 kg | 0.011 kg
3 | 2302-轴轴 | 2 | 铝 1060 | 0.009 kg | 0.018 kg
2 | 2310-前传动轴前 | 2 | 铝 1060 | 0.438 kg | 0.877 kg
1 | 2320-转动轴（前） | 1 | 铝 1060 | 0.771 kg | 0.771 kg

签 字 | 日 期 | 物 料 编 码 | 1001-2300 | 2300-前传动轴
设 计 | 陈煜暄 | 2025/9/10

校 对 | 丁文华 | | 宁波宁工机器人科技有限公司 | 图样标记 | 重 量 | 比 例 1:2 审 核 | 版 本

工 艺
标准化
审 定 | | | 西门子工业软件
批 准 | 否 | 2025/9/10
