cyx3705/2025-001/b-Module-2D/2310-前传动轴架.pdf

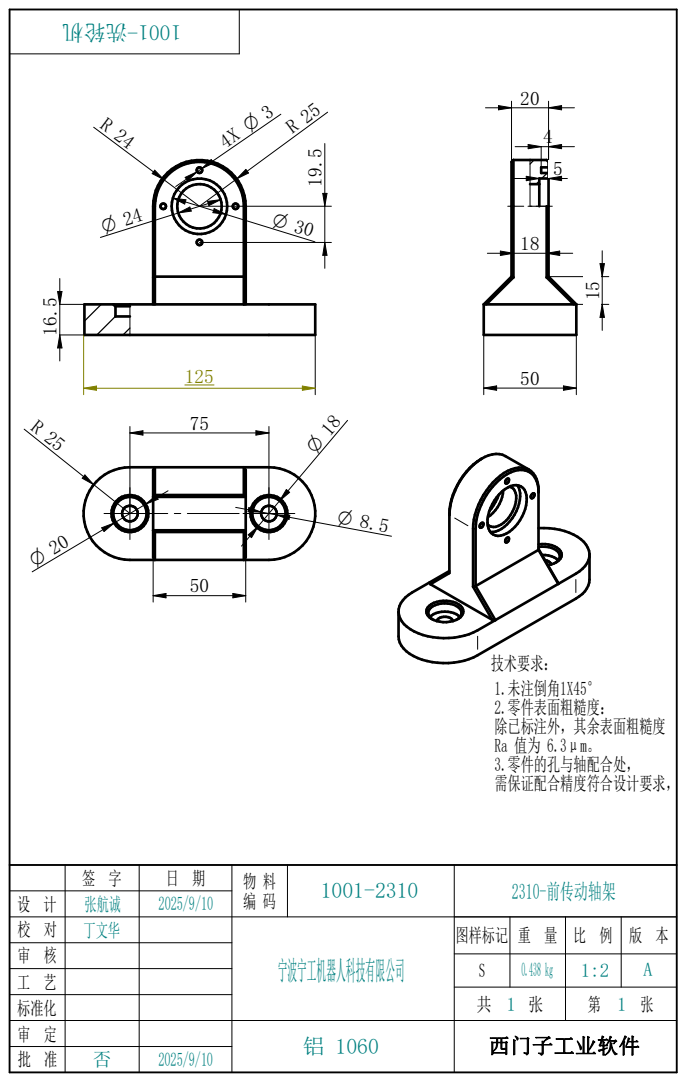
[picture p54: page 1]
技术要求：; 1.未注倒角1X45° 2.零件表面粗糙度： 除已标注外，其余表面粗糙度 Ra 值为 6.3μm。 3.零件的孔与轴配合处， 需保证配合精度符合设计要求，

设 计 | 签 字 | 日 期 | 物 料 编 码 | 1001-2310 | 2310-前传动轴架

张航诚 | 2025/9/10

校 对 | 丁文华 | | 宁波宁工机器人科技有限公司 | 图样标记 | 重 量 | 比 例 1:2 审 核 | 版 本

S | 0.438 kg | | A
共 1 张 | | 第 1 张

工 艺
标准化
审 定 | 否 | 2025/9/10 | 铝 1060 | 西门子工业软件
批 准
