cyx3705/2025-001/b-Module-2D/2320-转动轴（前）.pdf

### 详图 I 1:1

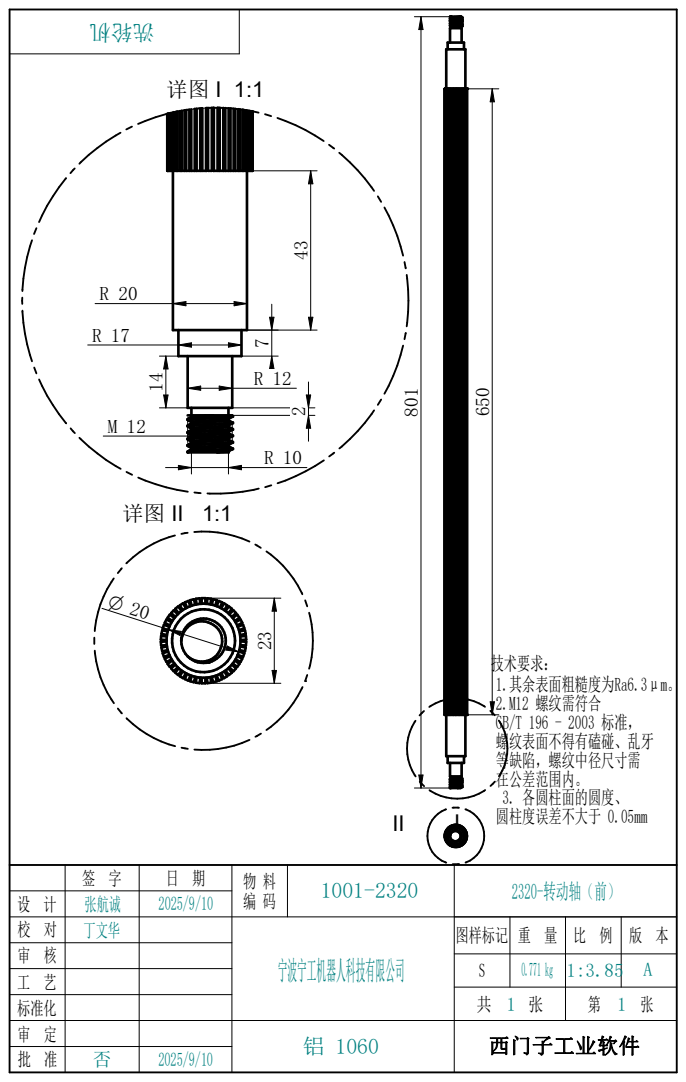
[picture p55: page 1]
技术要求：; 1.其余表面粗糙度为Ra6.3μm。 2.M12 螺纹需符合 GB/T 196 - 2003 标准， 螺纹表面不得有磕碰、乱牙 等缺陷，螺纹中径尺寸需 在公差范围内。 3. 各圆柱面的圆度、 圆柱度误差不大于 0.05mm

设 计 | 签 字 | 日 期 | 物 料 编 码 | 1001-2320 | 2320-转动轴（前）

张航诚 | 2025/9/10

校 对 | 丁文华 | | 宁波宁工机器人科技有限公司 | 图样标记 | 重 量 | 比 例 1:3.85 审 核 | 版 本

S | 0.771 kg | | A
共 1 张 | | 第 1 张

工 艺
标准化
审 定 | 否 | 2025/9/10 | 铝 1060 | 西门子工业软件
批 准
