cyx3705/2025-001/b-Module-2D/2340-环.pdf

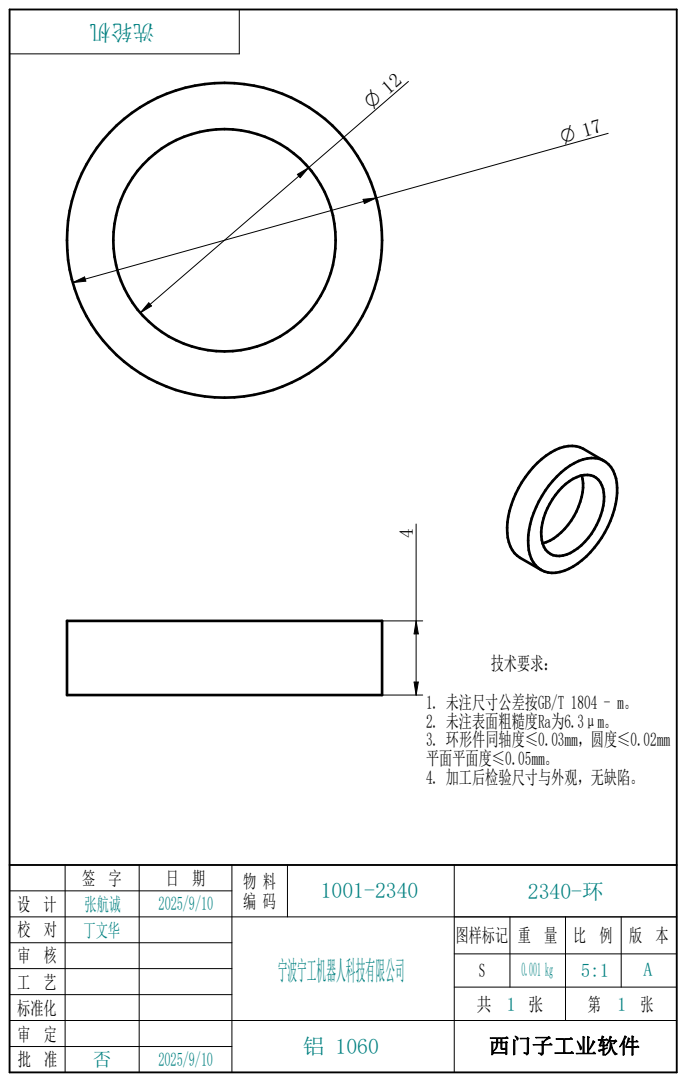
[picture p57: page 1]
技术要求：; 1. 未注尺寸公差按GB/T 1804 - m。 2. 未注表面粗糙度Ra为6.3μm。 3. 环形件同轴度≤0.03mm，圆度≤0.02mm 平面平面度≤0.05mm。 4. 加工后检验尺寸与外观，无缺陷。

张航诚 | 2025/9/10

校 对 | 丁文华 | | 宁波宁工机器人科技有限公司 | 图样标记 | 重 量 | 比 例 5:1 审 核 | 版 本

S | 0.001 kg | | A
共 1 张 | | 第 1 张

工 艺
标准化
审 定 | 否 | 2025/9/10 | 铝 1060 | 西门子工业软件
批 准
