cyx3705/2025-001/b-Module-2D/2410-后传动轴1.pdf

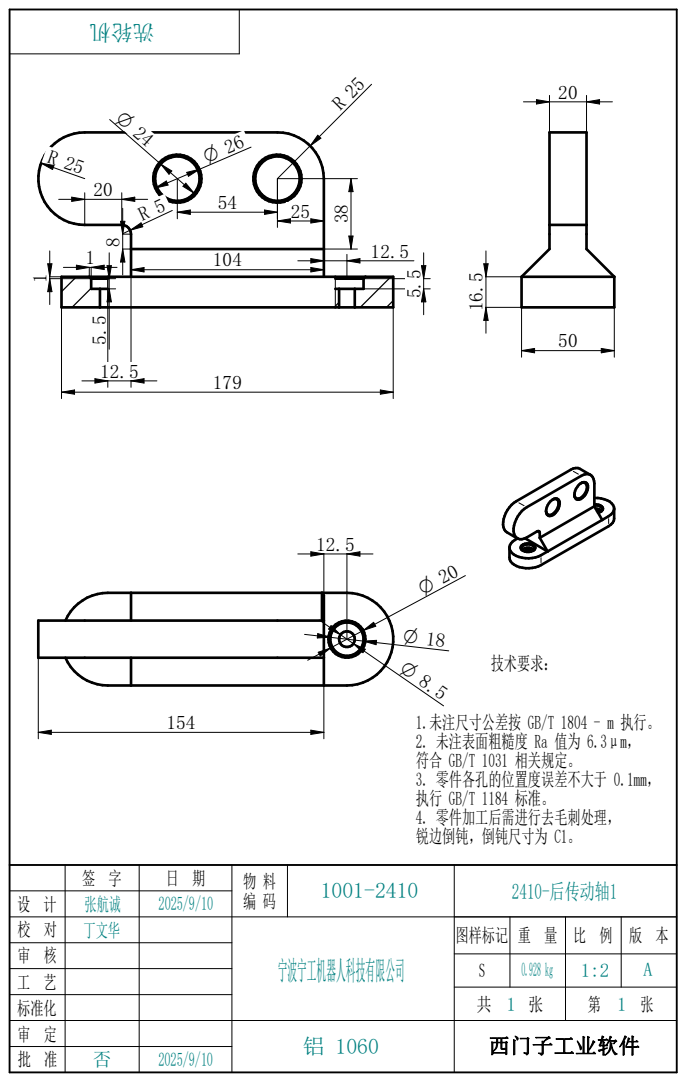
[picture p58: page 1]
技术要求：

1.未注尺寸公差按 GB/T 1804 - m 执行。
2. 未注表面粗糙度 Ra 值为 6.3μm，
符合 GB/T 1031 相关规定。
3. 零件各孔的位置度误差不大于 0.1mm，
4. 零件加工后需进行去毛刺处理，
锐边倒钝，倒钝尺寸为 C1。

设 计 | 签 字 | 日 期 | 物 料 编 码 | 1001-2410 | 2410-后传动轴1

张航诚 | 2025/9/10

校 对 | 丁文华 | | 宁波宁工机器人科技有限公司 | 图样标记 | 重 量 | 比 例 1:2 审 核 | 版 本

S | 0.928 kg | | A
共 1 张 | | 第 1 张

工 艺
标准化
审 定 | 否 | 2025/9/10 | 铝 1060 | 西门子工业软件
批 准
