cyx3705/2025-001/b-Module-2D/2420-后传动轴架2.pdf

A

### 剖剖 A-A

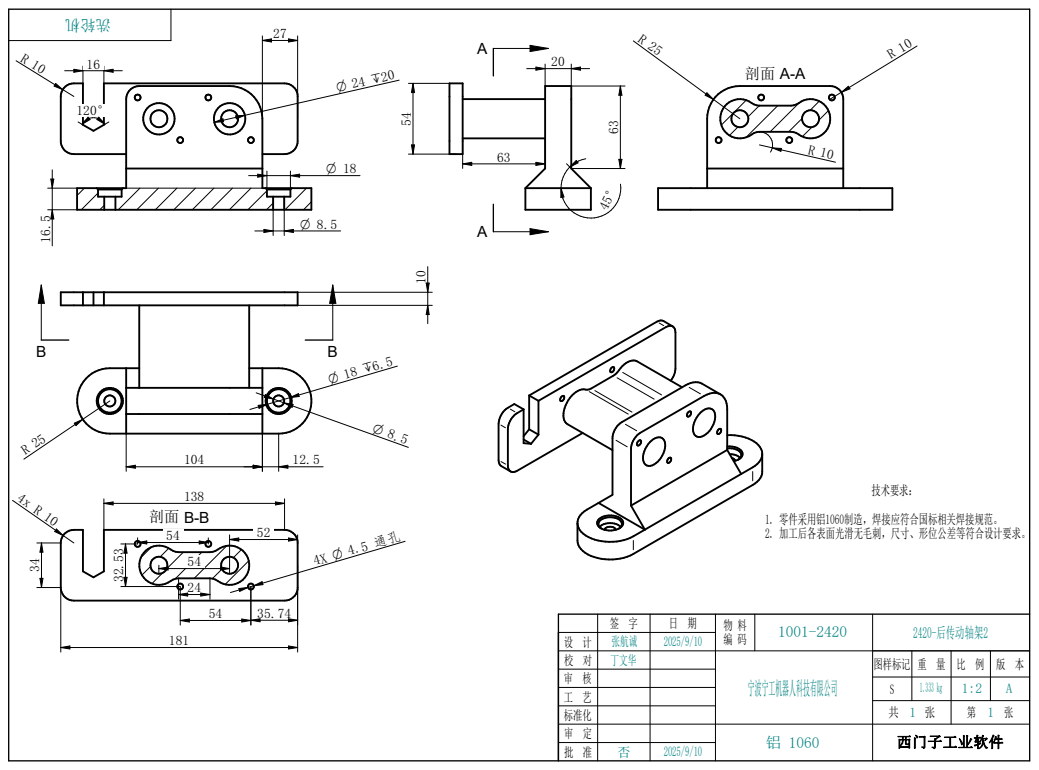
[picture p59: page 1]
技术要求：

1. 零件采用铝1060制造，焊接应符合国标相关焊接规范。
2. 加工后各表剖光滑无毛刺，尺寸、形位公差等符合设计要求。

设 计 | 签 字 | 日 期 | 物 料 编 码 | 1001-2420 | 2420-后传动轴架2

张航诚 | 2025/9/10

校 对 | 丁文华 | | 宁波宁工机器人科技有限公司 | 图样标记 | 重 量 | 比 例 1:2 审 核 | 版 本

S | 1.333 kg | | A
共 1 张 | | 第 1 张

工 艺
标准化
审 定 | 否 | 2025/9/10 | 铝 1060 | 西门子工业软件
批 准
