cyx3705/2025-001/b-Module-2D/3100-顶板（双门带锁）.pdf

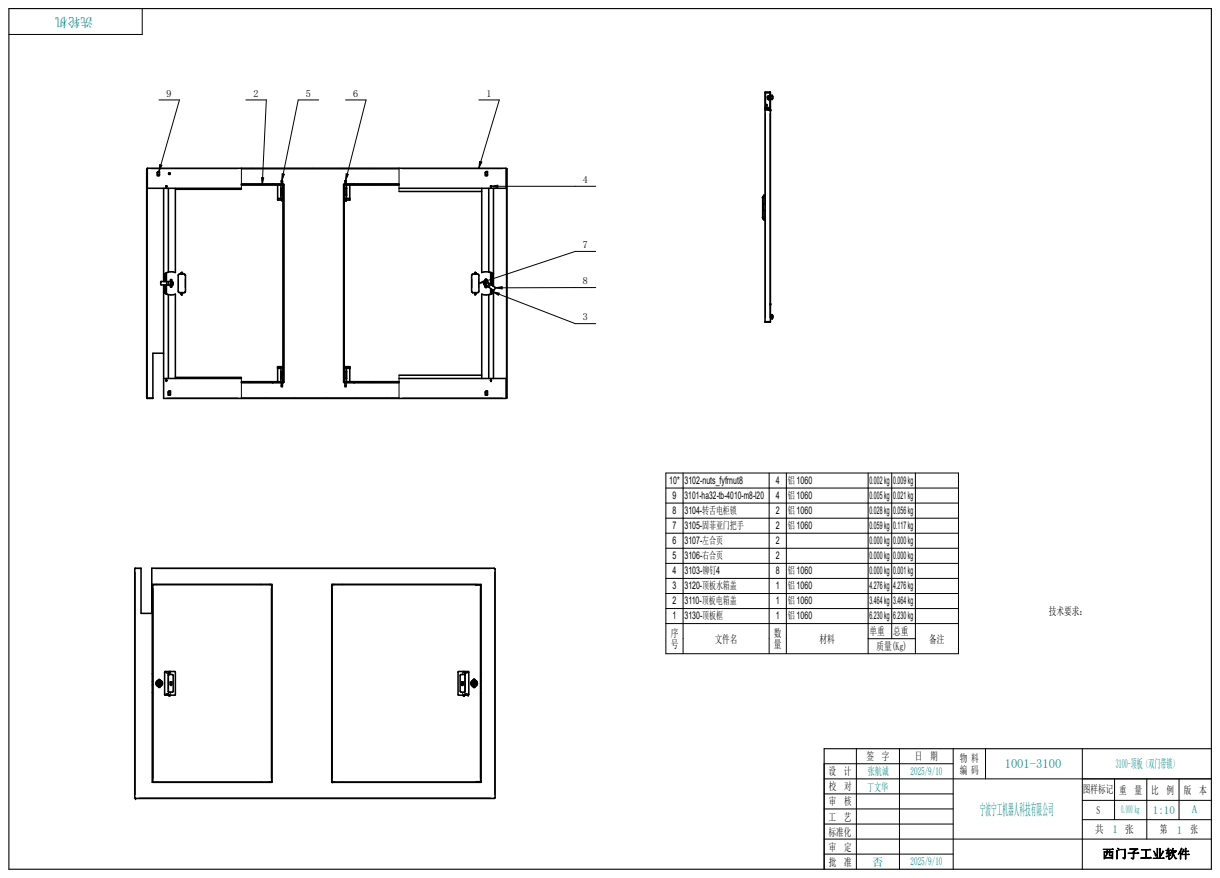
[picture p60: page 1]
技术要求：

10* | 3102-nuts_fyfrnut8 | 4 | 铝 1060 | 0.002 kg 0.009 kg
9 | 3101-ha32-tb-4010-m8-l20 | 4 | 铝 1060 | 0.005 kg 0.021 kg
8 | 3104-转转转转锁 | 2 | 铝 1060 | 0.028 kg 0.056 kg
7 | 3105-固固固门固固 | 2 | 铝 1060 | 0.059 kg 0.117 kg
6 | 3107-左左左 | 2 | | 0.000 kg
5 | 3106-右左左 | 2 | | 0.000 kg
4 | 3103- 4 铆铆 | 8 | 铝 1060 | 0.000 kg 0.001 kg
3 | 3120-顶板顶顶顶 | 1 | 铝 1060 | 4.276 kg
2 | 3110-顶板转顶顶 | 1 | 铝 1060 | 3.464 kg
1 | 3130-顶板顶 | 1 | 铝 1060 | 6.230 kg
序 号 | 文件名 | 数

签 字 | 日 期 | 物 料 编 码 | 1001-3100 | 3100-顶板（双门带锁）
设 计 | 张航诚 | 2025/9/10

校 对 | 丁文华 | | 宁波宁工机器人科技有限公司 | 图样标记 | 重 量 | 比 例 1:10 审 核 | 版 本

工 艺
标准化
审 定 | | | 西门子工业软件
批 准 | 否 | 2025/9/10
