cyx3705/2025-001/b-Module-2D/3120-顶板水箱盖 .pdf

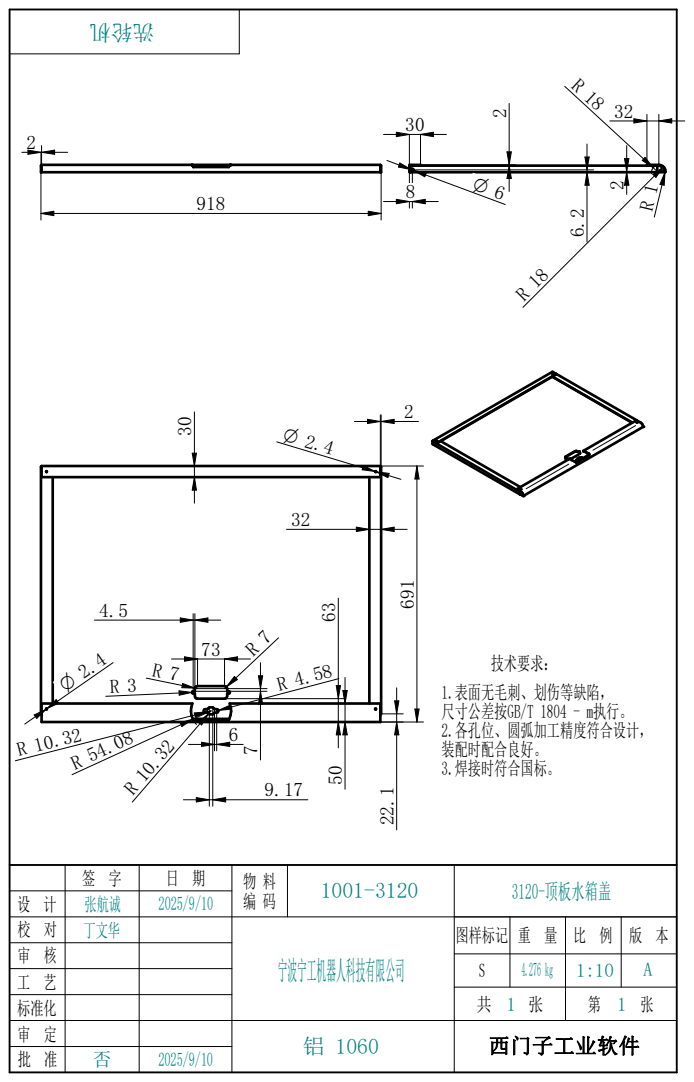
[picture p61: page 1]
技术要求：; 1.表面无毛刺、划伤等缺陷， 尺寸公差按GB/T 1804 - m执行。 2.各孔位、圆弧加工精度符合设计， 装配时配合良好。 3.焊接时符合国标。

设 计 | 签 字 | 日 期 | 物 料 编 码 | 1001-3120 | 3120-顶板水箱盖

张航诚 | 2025/9/10

校 对 | 丁文华 | | 宁波宁工机器人科技有限公司 | 图样标记 | 重 量 | 比 例 1:10 审 核 | 版 本

S | 4.276 kg | | A
共 1 张 | | 第 1 张

工 艺
标准化
审 定 | 否 | 2025/9/10 | 铝 1060 | 西门子工业软件
批 准
