cyx3705/2025-001/b-Module-2D/3130-顶板框.pdf

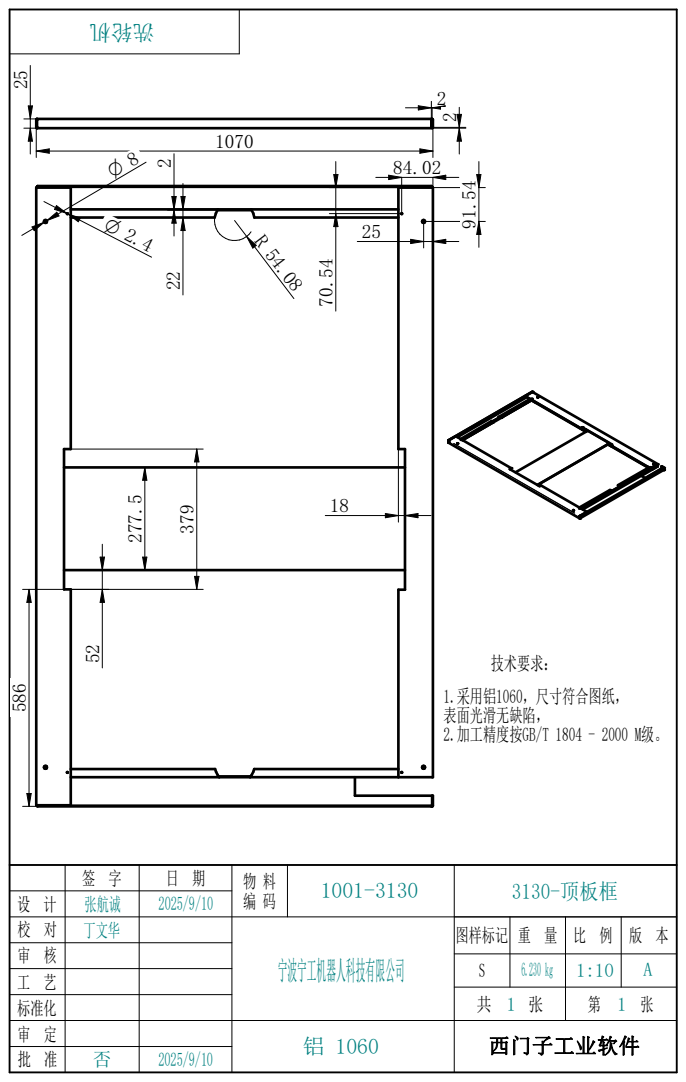
[picture p62: page 1]
技术要求：; 1.采用铝1060，尺寸符合图纸， 表面光滑无缺陷， 2.加工精度按GB/T 1804 - 2000 M级。

设 计 | 签 字 | 日 期 | 物 料 编 码 | 1001-3130 | 3130-顶板框

张航诚 | 2025/9/10

校 对 | 丁文华 | | 宁波宁工机器人科技有限公司 | 图样标记 | 重 量 | 比 例 1:10 审 核 | 版 本

S | 6.230 kg | | A
共 1 张 | | 第 1 张

工 艺
标准化
审 定 | 否 | 2025/9/10 | 铝 1060 | 西门子工业软件
批 准
