cyx3705/2025-001/b-Module-2D/3200-小车入口盖板.pdf

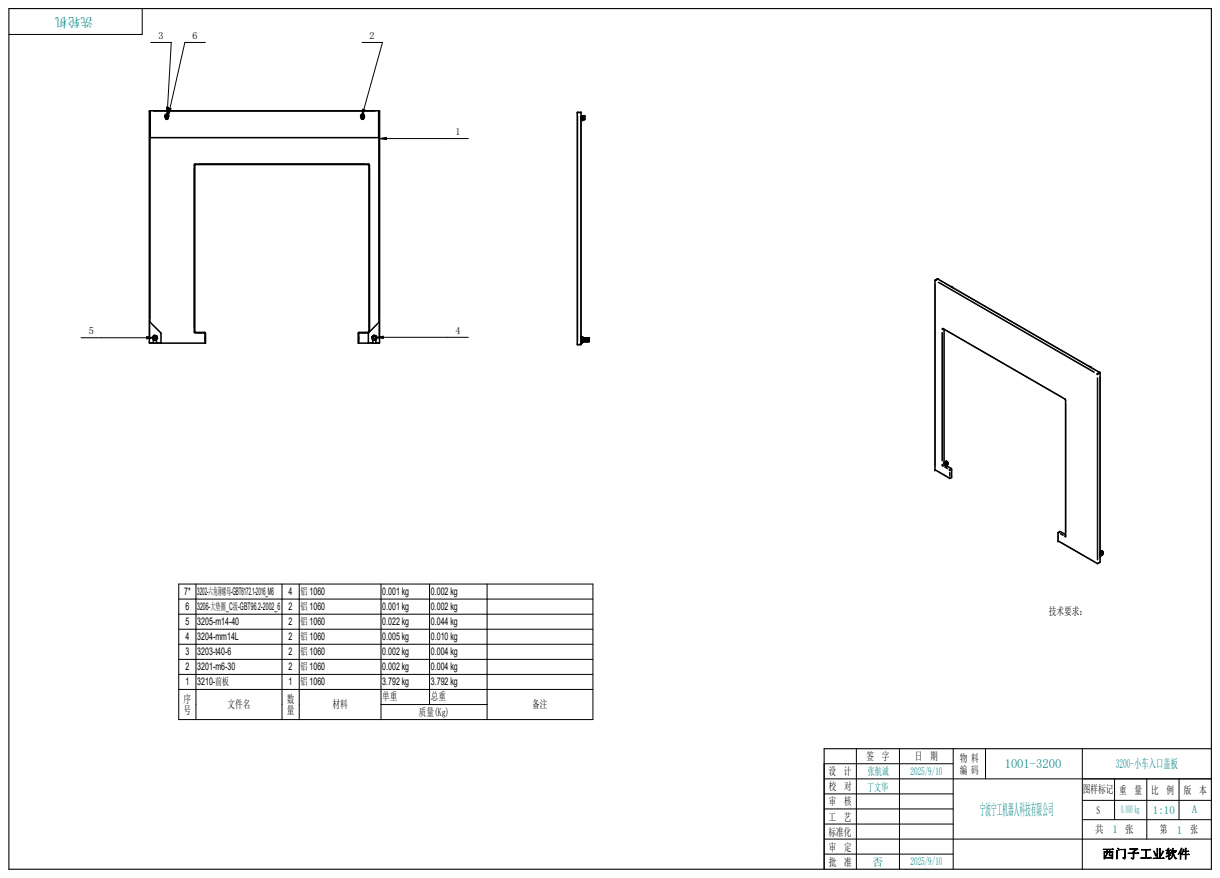
[picture p63: page 1]
技术要求：; 文件名

7* | 3202--GBT6172.1- 六六六六六 2016_M6 | 4 | 铝 1060 | 0.001 kg | 0.002 kg
6 | 3206-_C -GBT96.2-2002_6 大大大 级 | 2 | 铝 1060 | 0.001 kg | 0.002 kg
5 | 3205-m14-40 | 2 | 铝 1060 | 0.022 kg | 0.044 kg
4 | 3204-mm14L | 2 | 铝 1060 | 0.005 kg | 0.010 kg
3 | 3203-t40-6 | 2 | 铝 1060 | 0.002 kg | 0.004 kg
2 | 3201-m6-30 | 2 | 铝 1060 | 0.002 kg | 0.004 kg
1 | 3210-前板 | 1 | 铝 1060 | 3.792 kg | 3.792 kg

签 字 | 日 期 | 物 料 编 码 | 1001-3200 | 3200-小车入口盖板
设 计 | 张航诚 | 2025/9/10

校 对 | 丁文华 | | 宁波宁工机器人科技有限公司 | 图样标记 | 重 量 | 比 例 1:10 审 核 | 版 本

工 艺
标准化
审 定 | | | 西门子工业软件
批 准 | 否 | 2025/9/10
