cyx3705/2025-001/b-Module-2D/3210-前板.pdf

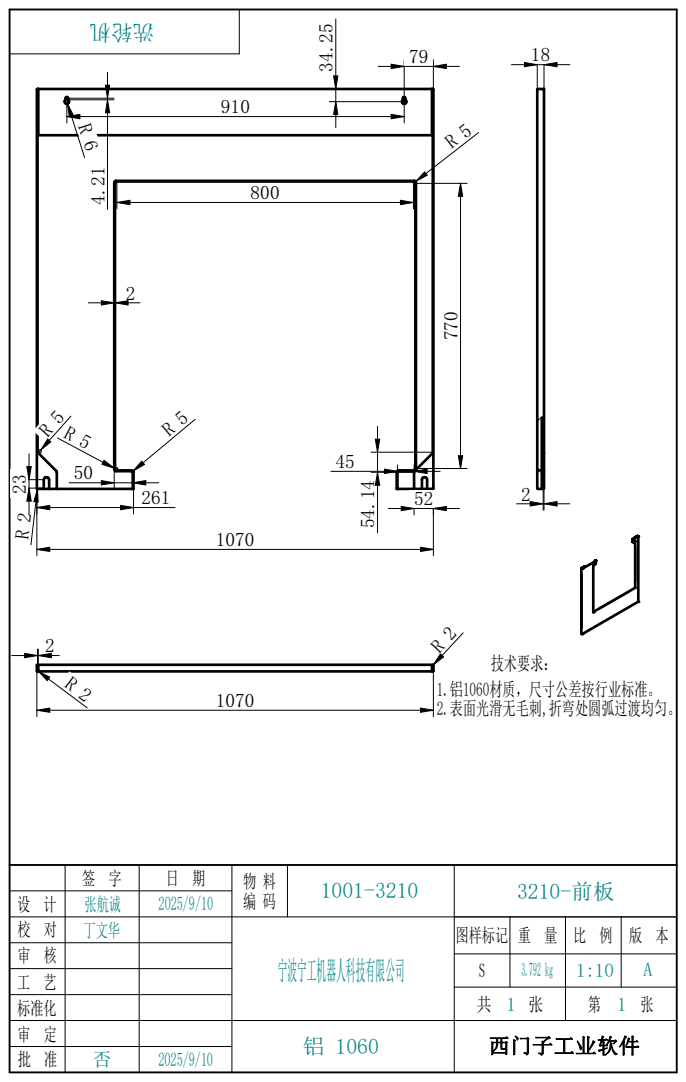
[picture p64: page 1]
技术要求：; 1.铝1060材质，尺寸公差按行业标准。 2.表面光滑无毛刺,折弯处圆弧过渡均匀。

张航诚 | 2025/9/10

校 对 | 丁文华 | | 宁波宁工机器人科技有限公司 | 图样标记 | 重 量 | 比 例 1:10 审 核 | 版 本

S | 3.792 kg | | A
共 1 张 | | 第 1 张

工 艺
标准化
审 定 | 否 | 2025/9/10 | 铝 1060 | 西门子工业软件
批 准
