cyx3705/2025-001/b-Module-2D/3310-背板（大）.pdf

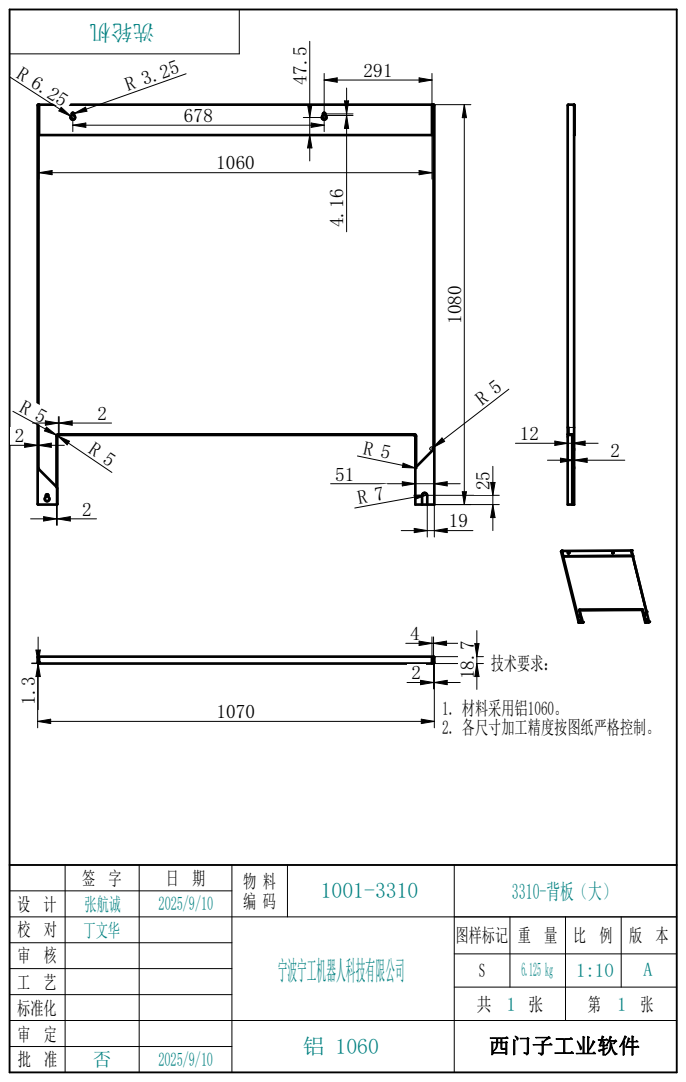
[picture p65: page 1]
技术要求：; 1. 材料采用铝1060。; 2. 各尺寸加工精度按图纸严格控制。

张航诚 | 2025/9/10

校 对 | 丁文华 | | 宁波宁工机器人科技有限公司 | 图样标记 | 重 量 | 比 例 1:10 审 核 | 版 本

S | 6.125 kg | | A
共 1 张 | | 第 1 张

工 艺
标准化
审 定 | 否 | 2025/9/10 | 铝 1060 | 西门子工业软件
批 准
