cyx3705/2025-001/b-Module-2D/3400-侧板.pdf

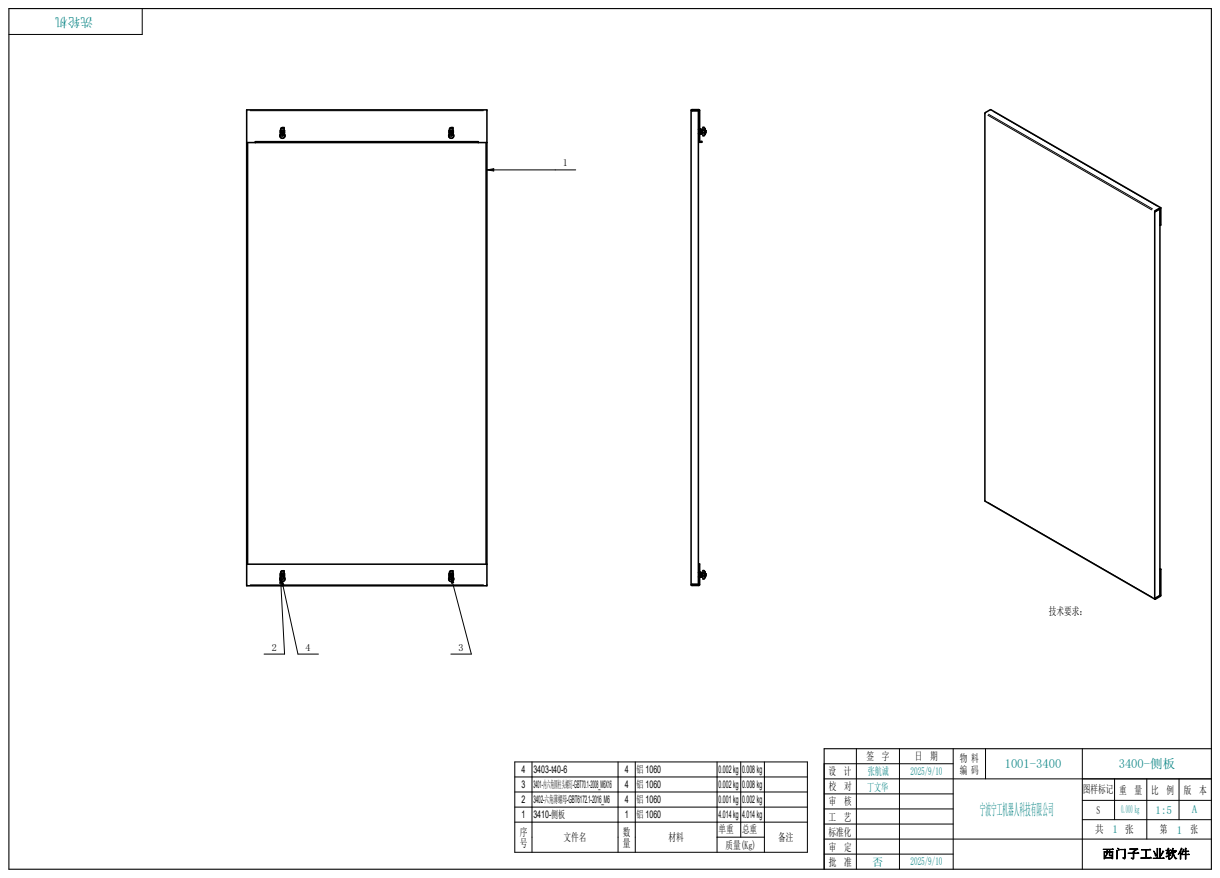
[picture p66: page 1]
图样标记; 宁波宁工机器人科技有限公司; 张航诚; 丁文华; 技术要求：; -GBT70.1- 内内内内内内内内; 文件名

2 | 3402--GBT6172.1- 内内六内六 2016_M6 | 4 | 铝 1060 | 0.001 kg 0.002 kg
1 | 3410-侧板 | 1 | 铝 1060 | 4.014 kg

工 艺
标准化
审 定 | | | 西门子工业软件
批 准 | 否 | 2025/9/10
