cyx3705/2025-001/b-Module-2D/3410-侧板.pdf

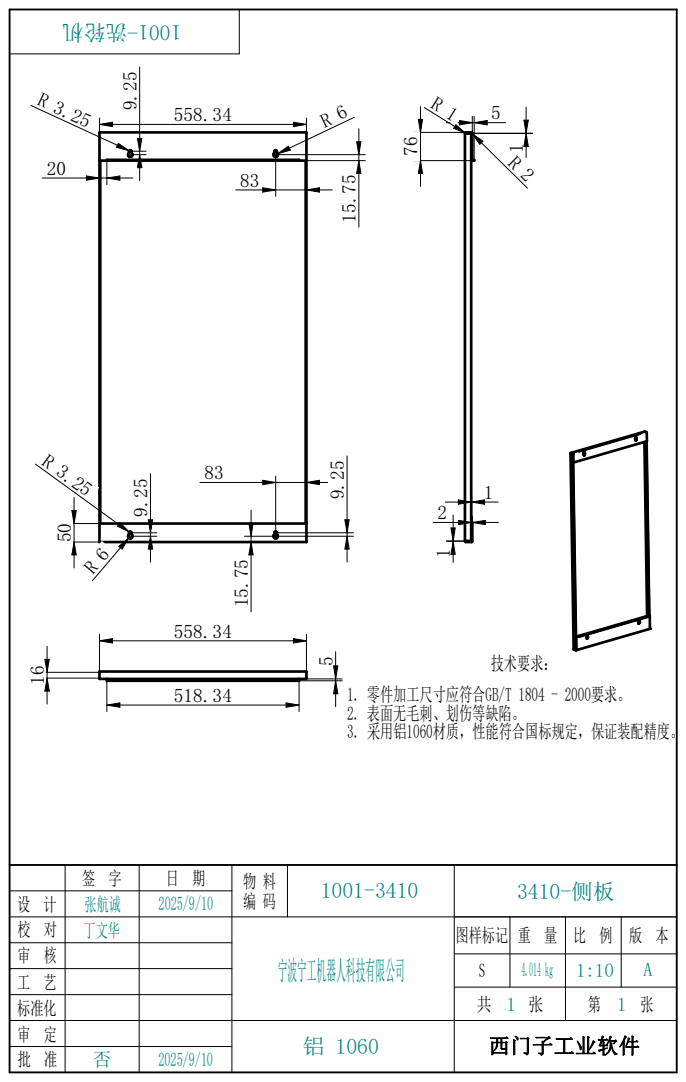
[picture p67: page 1]
技术要求：; 1. 零件加工尺寸应符合GB/T 1804 - 2000要求。 2. 表面无毛刺、划伤等缺陷。 3. 采用铝1060材质，性能符合国标规定，保证装配精度。

张航诚 | 2025/9/10

校 对 | 丁文华 | | 宁波宁工机器人科技有限公司 | 图样标记 | 重 量 | 比 例 1:10 审 核 | 版 本

S | 4.014 kg | | A
共 1 张 | | 第 1 张

工 艺
标准化
审 定 | 否 | 2025/9/10 | 铝 1060 | 西门子工业软件
批 准
