cyx3705/2025-001/b-Module-2D/4320-上固定.pdf

### 剖剖 A-A

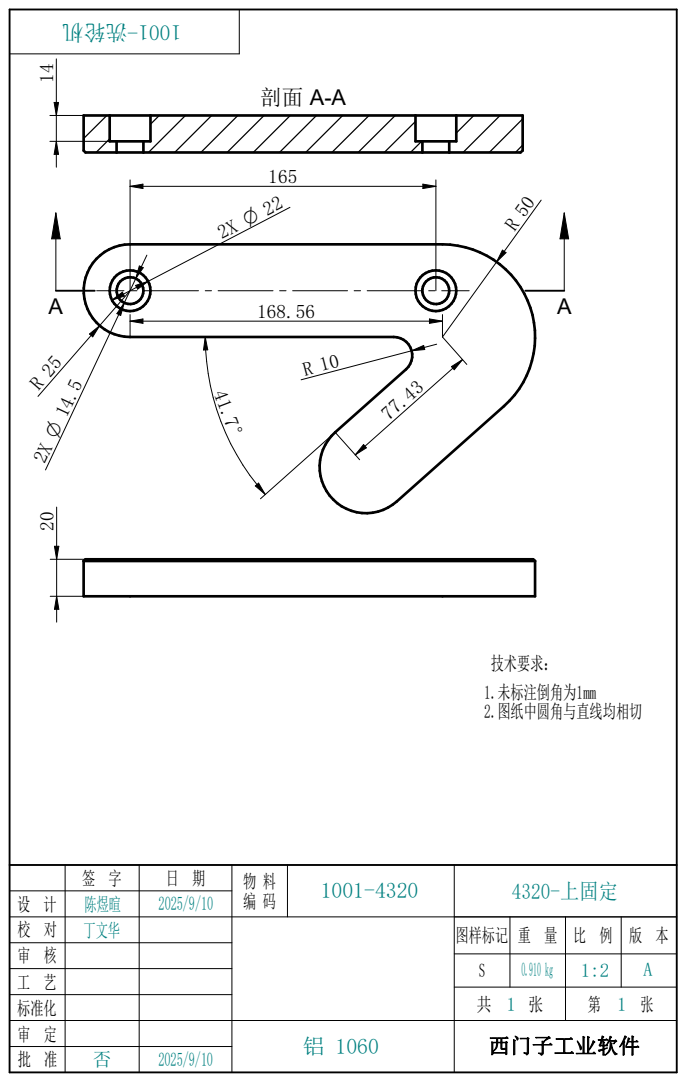
[picture p71: page 1]
技术要求：; 1.未标注倒角为1mm 2.图纸中圆角与直线均相切

设 计 | 签 字 | 日 期 | 物 料 编 码 | 1001-4320 | 4320-上固定

陈煜暄 | 2025/9/10

校 对 | 丁文华 | | | 图样标记 | 重 量 | 比 例 1:2 审 核 | 版 本

S | 0.910 kg | | A
共 1 张 | | 第 1 张

工 艺
标准化
审 定 | 否 | 2025/9/10 | 铝 1060 | 西门子工业软件
批 准
