cyx3705/2025-001/b-Module-2D/4340-开关挡片.pdf

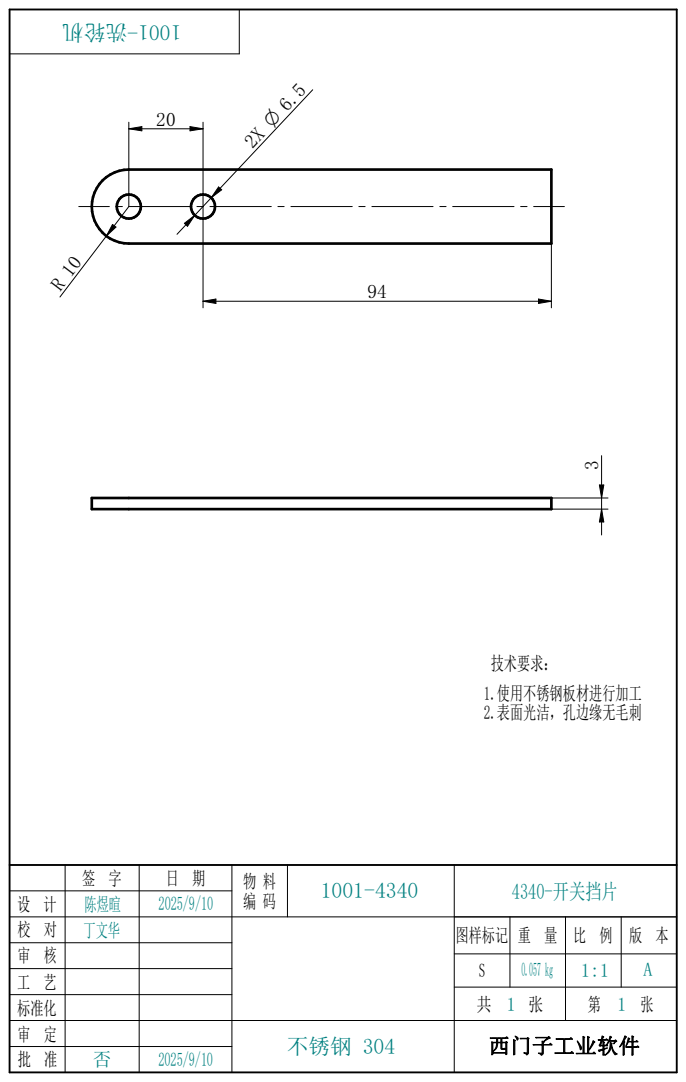
[picture p72: page 1]
技术要求：; 1.使用不锈钢板材进行加工 2.表面光洁，孔边缘无毛刺

设 计 | 签 字 | 日 期 | 物 料 编 码 | 1001-4340 | 4340-开关挡片

陈煜暄 | 2025/9/10

校 对 | 丁文华 | | | 图样标记 | 重 量 | 比 例 1:1 审 核 | 版 本

S | 0.057 kg | | A
共 1 张 | | 第 1 张

工 艺
标准化
审 定 | 否 | 2025/9/10 | 不锈钢 304 | 西门子工业软件
批 准
