cyx3705/2025-001/b-Module-2D/4600-左连杆.pdf

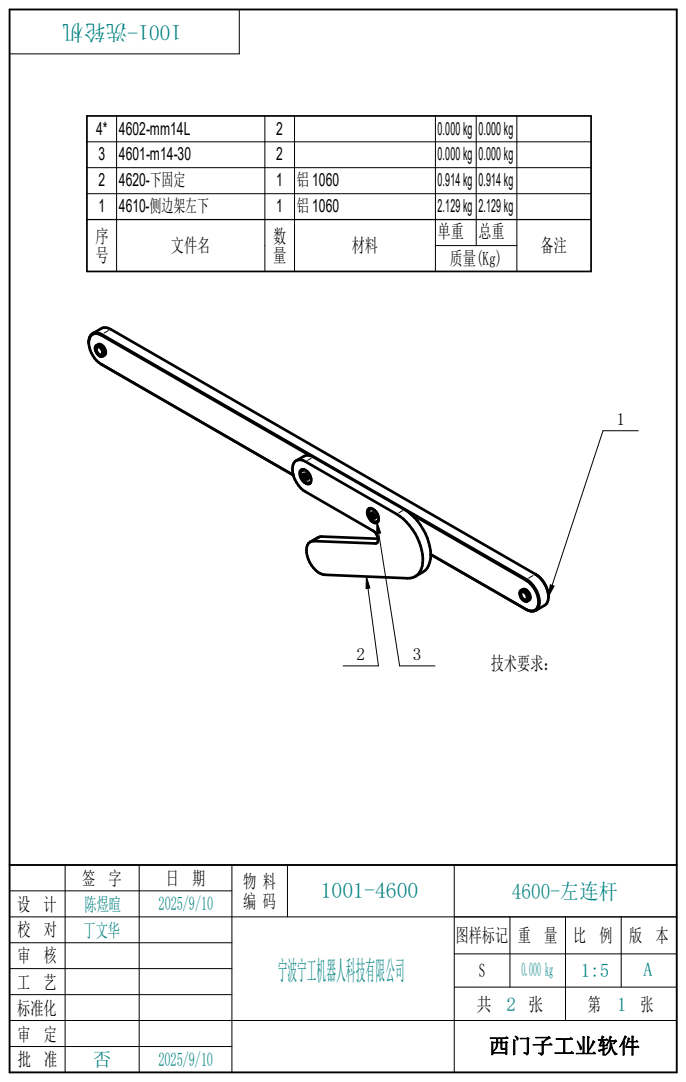
[picture p74: page 1]
技术要求： 3

4* | 4602-mm14L | 2 | | 0.000 kg
3 | 4601-m14-30 | 2 | | 0.000 kg
2 | 4620-下下定 | 1 | 铝 1060 | 0.914 kg
1 | 4610-侧侧侧左下 | 1 | 铝 1060 | 2.129 kg
序 号 | 文件名 | 数

设 计 | 签 字 | 日 期 | 物 料 编 码 | 1001-4600 | 4600-左连杆

陈煜暄 | 2025/9/10

校 对 | 丁文华 | | 宁波宁工机器人科技有限公司 | 图样标记 | 重 量 | 比 例 1:5 审 核 | 版 本

工 艺
标准化
审 定 | 否 | 2025/9/10 | 西门子工业软件
批 准
