cyx3705/2025-001/b-Module-2D/4610-侧边架左下.pdf

### 剖剖 B-B

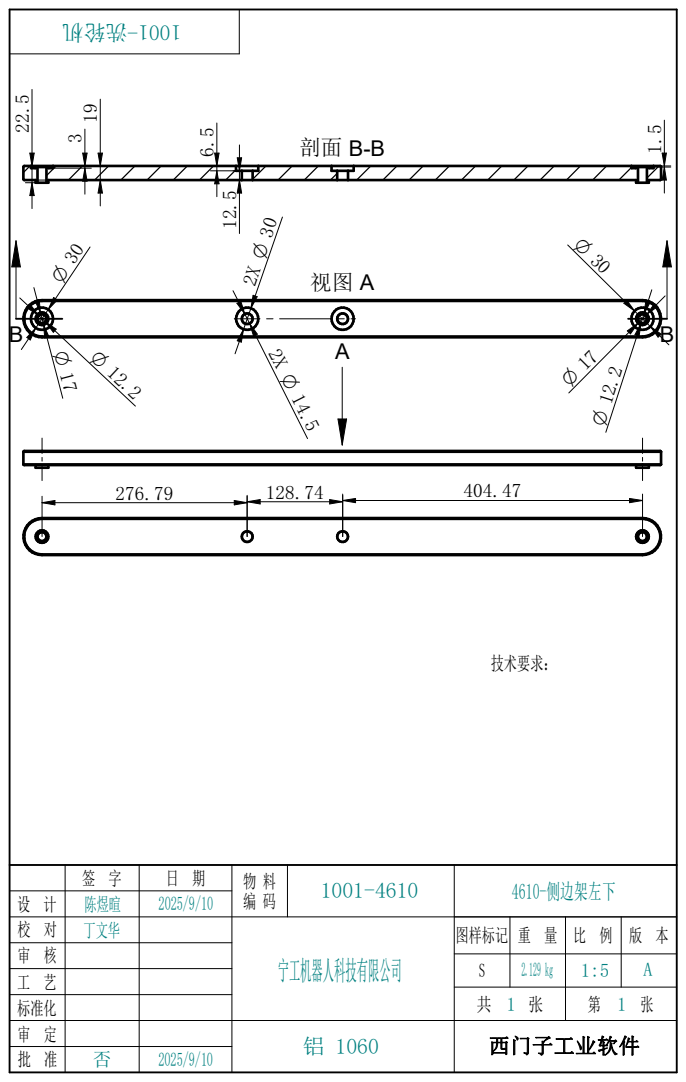
[picture p75: page 1]
技术要求：

设 计 | 签 字 | 日 期 | 物 料 编 码 | 1001-4610 | 4610-侧边架左下

陈煜暄 | 2025/9/10

校 对 | 丁文华 | | 宁工机器人科技有限公司 | 图样标记 | 重 量 | 比 例 1:5 审 核 | 版 本

S | 2.129 kg | | A
共 1 张 | | 第 1 张

工 艺
标准化
审 定 | 否 | 2025/9/10 | 铝 1060 | 西门子工业软件
批 准
