cyx3705/2025-001/b-Module-2D/4700-右连杆.pdf

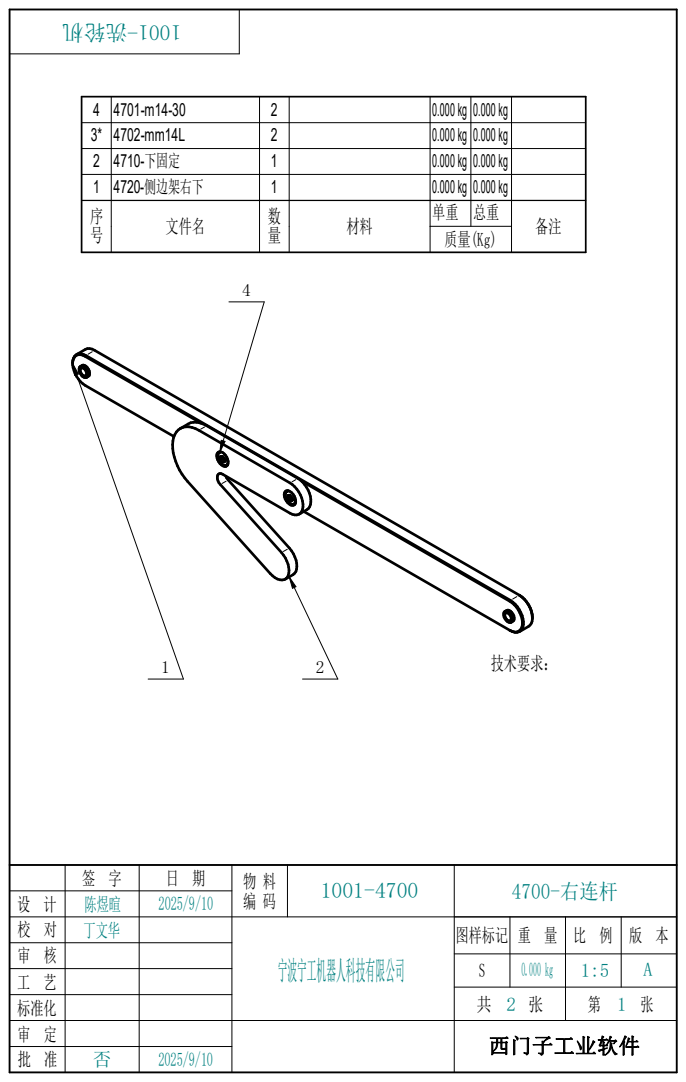
[picture p77: page 1]
技术要求：

4 | 4701-m14-30 | 2 | 0.000 kg
3* | 4702-mm14L | 2 | 0.000 kg
2 | 4710-下下定 | 1 | 0.000 kg
1 | 4720-侧侧侧右下 | 1 | 0.000 kg
序 号 | 文件名 | 数

设 计 | 签 字 | 日 期 | 物 料 编 码 | 1001-4700 | 4700-右连杆

陈煜暄 | 2025/9/10

校 对 | 丁文华 | | 宁波宁工机器人科技有限公司 | 图样标记 | 重 量 | 比 例 1:5 审 核 | 版 本

工 艺
标准化
审 定 | 否 | 2025/9/10 | 西门子工业软件
批 准
