cyx3705/2025-001/b-Module-2D/4800-脚钉.pdf

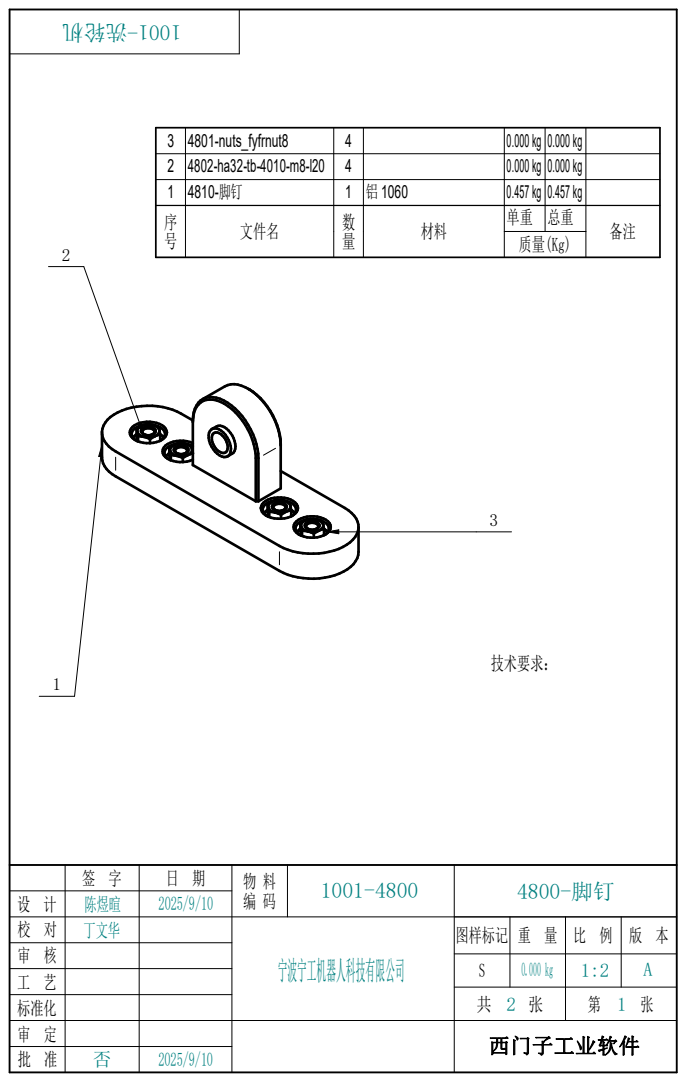
[picture p78: page 1]
技术要求：

3 | 4801-nuts_fyfrnut8 | 4 | | 0.000 kg
2 | 4802-ha32-tb-4010-m8-l20 | 4 | | 0.000 kg
1 | 4810-脚钉 | 1 | 铝 1060 | 0.457 kg
序 号 | 文件名 | 数

陈煜暄 | 2025/9/10

校 对 | 丁文华 | | 宁波宁工机器人科技有限公司 | 图样标记 | 重 量 | 比 例 1:2 审 核 | 版 本

工 艺
标准化
审 定 | 否 | 2025/9/10 | 西门子工业软件
批 准
