cyx3705/2025-001/b-Module-2D/4900-固定机构.pdf

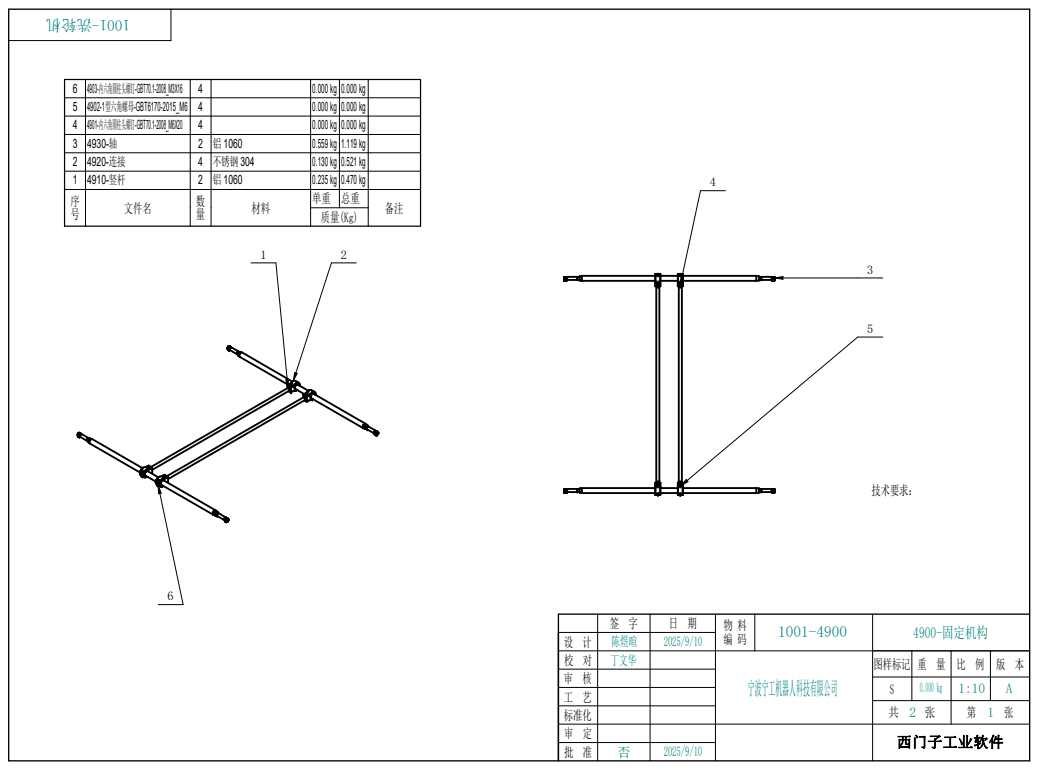
[picture p79: page 1]
技术要求：; 文件名

6 | 4903--GBT70.1- 内内内内内内内内 2008_M3X16 | 4 | | 0.000 kg
5 | 4902-1 -GBT 型内内内型 6170-2015_M6 | 4 | | 0.000 kg
4 | 4901--GBT70.1- 内内内内内内内内 2008_M6X20 | 4 | | 0.000 kg
3 | 4930-轴 | 2 | 铝 1060 | 0.559 kg 1.119 kg
2 | 4920-连连 | 4 | 不不不 304 | 0.130 kg 0.521 kg
1 | 4910-竖竖 | 2 | 铝 1060 | 0.235 kg 0.470 kg

设 计 | 签 字 | 日 期 | 物 料 编 码 | 1001-4900 | 4900-固定机构

陈煜暄 | 2025/9/10

校 对 | 丁文华 | | 宁波宁工机器人科技有限公司 | 图样标记 | 重 量 | 比 例 1:10 审 核 | 版 本

工 艺
标准化
审 定 | 否 | 2025/9/10 | 西门子工业软件
批 准
