cyx3705/2025-001/b-Module-2D/5300-连接.pdf

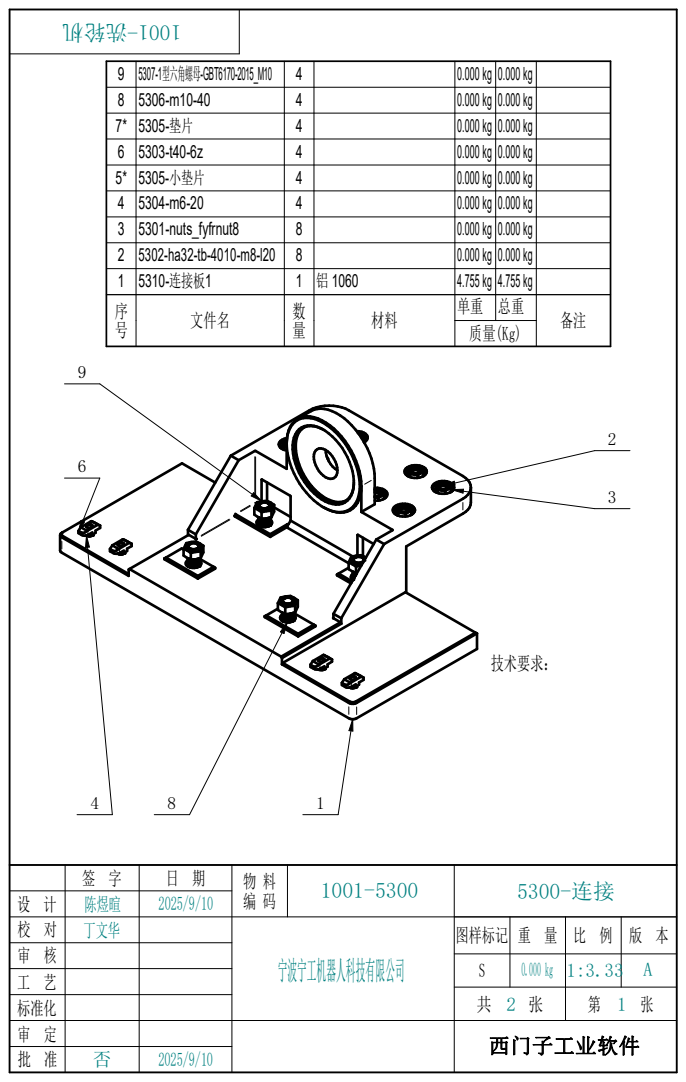
[picture p80: page 1]
技术要求：

9 | 5307-1 -GBT6 型型型型型 170-2015_M10 | 4 | | 0.000 kg
8 | 5306-m10-40 | 4 | | 0.000 kg
7* | 5305-垫垫 | 4 | | 0.000 kg
6 | 5303-t40-6z | 4 | | 0.000 kg
5* | 5305-小垫垫 | 4 | | 0.000 kg
4 | 5304-m6-20 | 4 | | 0.000 kg
3 | 5301-nuts_fyfrnut8 | 8 | | 0.000 kg
2 | 5302-ha32-tb-4010-m8-l20 | 8 | | 0.000 kg
1 | 5310-1 连接连 | 1 | 铝 1060 | 4.755 kg
序 号 | 文件名 | 数

陈煜暄 | 2025/9/10

校 对 | 丁文华 | | 宁波宁工机器人科技有限公司 | 图样标记 | 重 量 | 比 例 1:3.33 审 核 | 版 本

工 艺
标准化
审 定 | 否 | 2025/9/10 | 西门子工业软件
批 准
