cyx3705/2025-001/b-Module-2D/0320-绝缘板.pdf

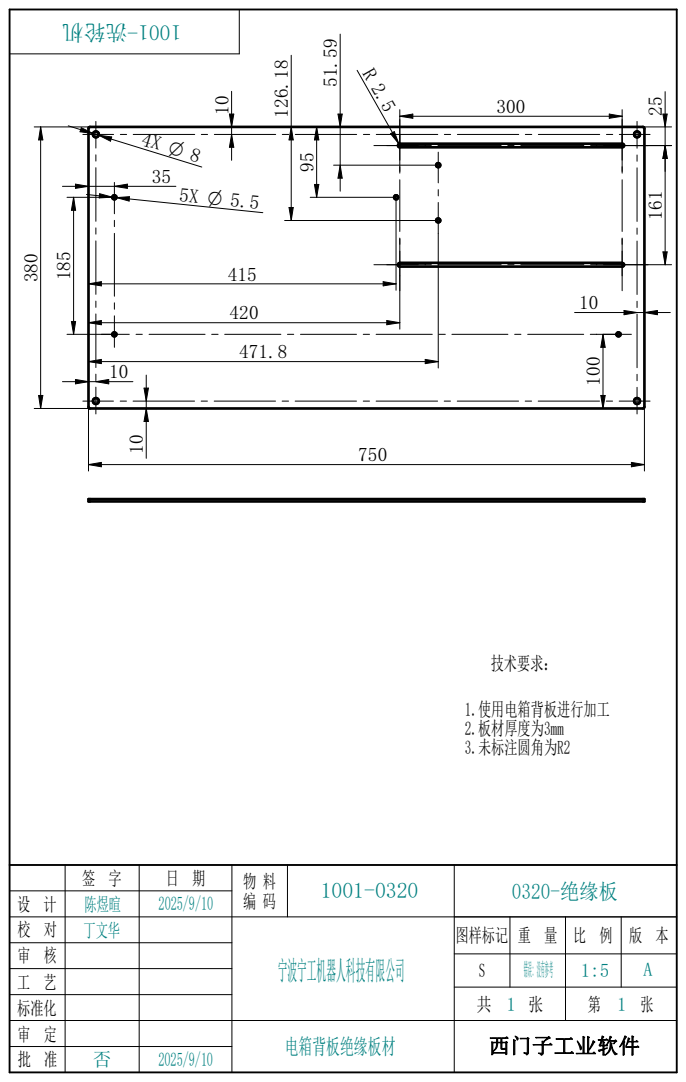
[picture p81: page 1]
技术要求：; 1.使用电箱背板进行加工 2.板材厚度为3mm 3.未标注圆角为R2

设 计 | 签 字 | 日 期 | 物 料 编 码 | 1001-0320 | 0320-绝缘板

陈煜暄 | 2025/9/10

校 对 | 丁文华 | | 宁波宁工机器人科技有限公司 | 图样标记 | 重 量 | 比 例 1:5 审 核 | 版 本

S | 错误: 没有参考 | | A
共 1 张 | | 第 1 张

工 艺
标准化
审 定 | 否 | 2025/9/10 | 电箱背板绝缘板材 | 西门子工业软件
批 准
