cyx3705/2025-001/b-Module-2D/1100-型材框架-A3.pdf

A

### 剖剖 A-A

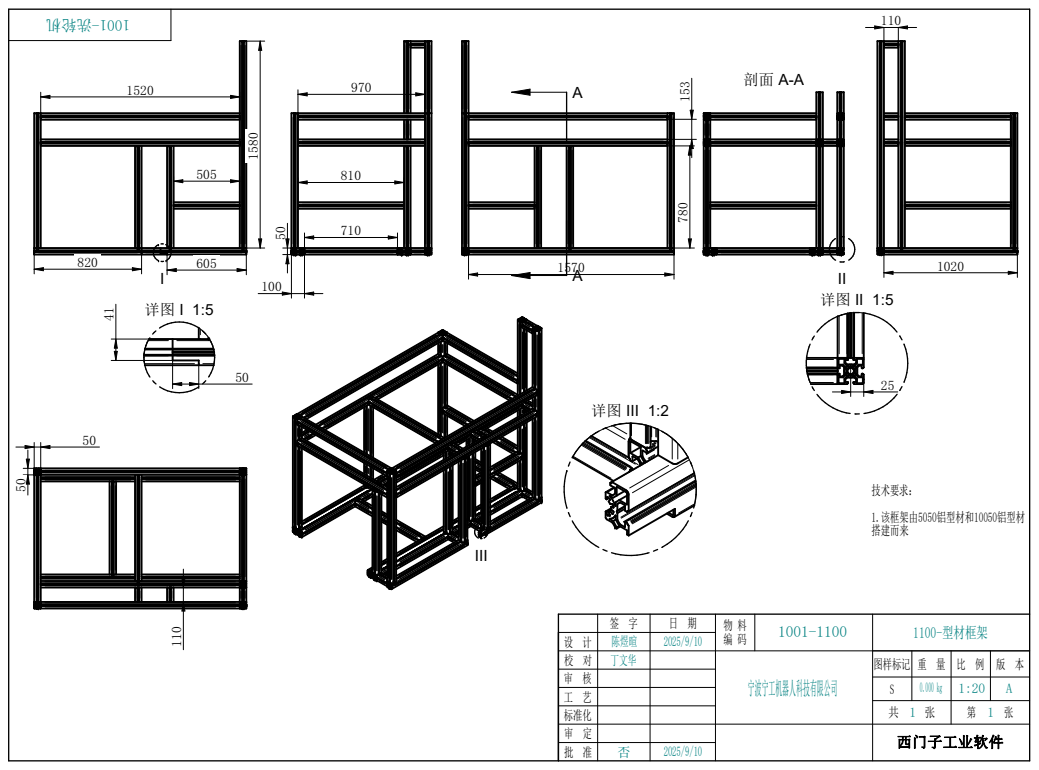
[picture p82: page 1]
技术要求：; III; 详图 III 1:2; 1.该框架由5050铝型材和10050铝型材 搭建而来

设 计 | 签 字 | 日 期 | 物 料 编 码 | 1001-1100 | 1100-型材框架

陈煜暄 | 2025/9/10

校 对 | 丁文华 | | 宁波宁工机器人科技有限公司 | 图样标记 | 重 量 | 比 例 1:20 审 核 | 版 本

工 艺
标准化
审 定 | 否 | 2025/9/10 | 西门子工业软件
批 准
