cyx3705/2025-001/b-Module-2D/2400-后传动轴.pdf

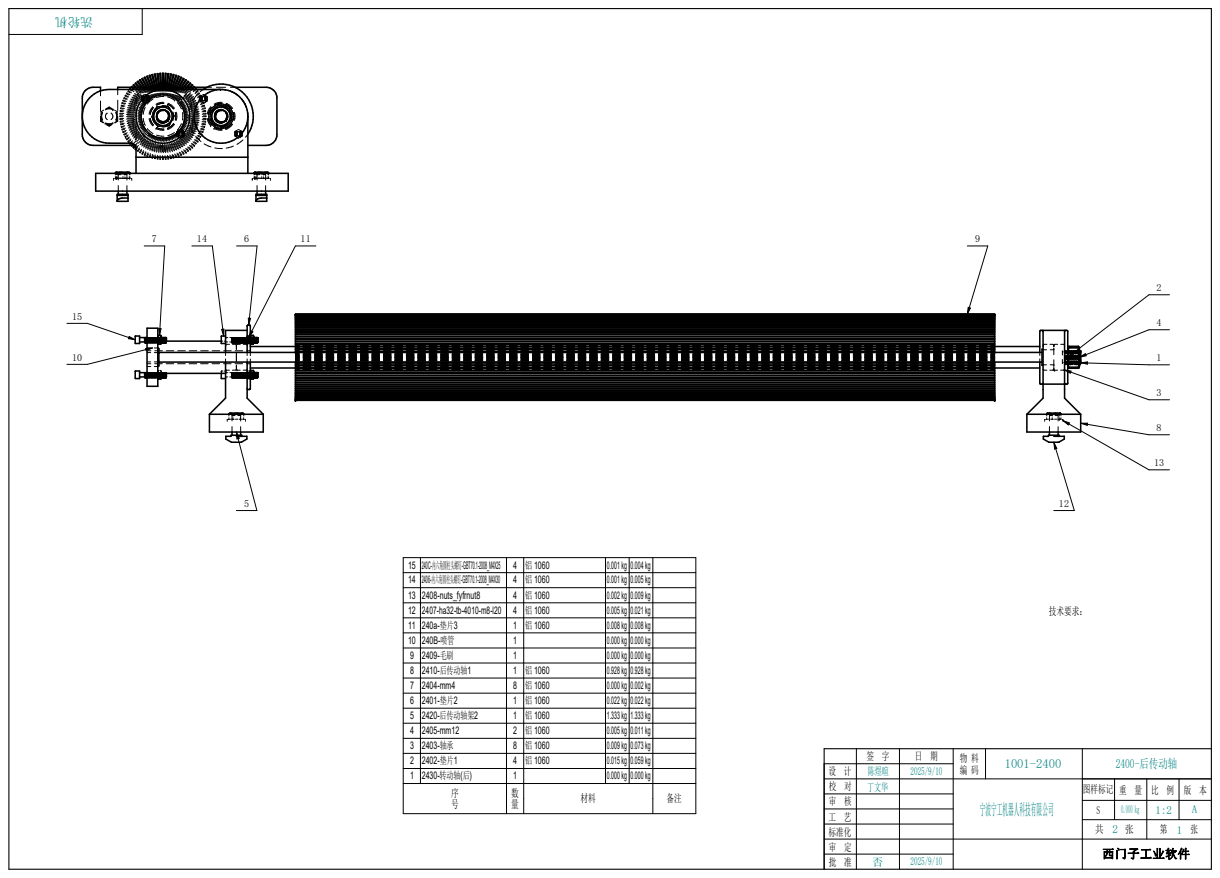
[picture p83: page 1]
技术要求：; -GBT70.1- 内内内内内内内内; 13 2408-nuts_fyfrnut8; 1 后传动轴; 2 后传动轴后; ( ) 转动轴 后

签 字 | 日 期 | 物 料 编 码 | 1001-2400 | 2400-后传动轴
设 计 | 陈煜暄 | 2025/9/10

校 对 | 丁文华 | | 宁波宁工机器人科技有限公司 | 图样标记 | 重 量 | 比 例 1:2 审 核 | 版 本

工 艺
标准化
审 定 | | | 西门子工业软件
批 准 | 否 | 2025/9/10
