cyx3705/2025-001/b-Module-2D/2430-转动轴(后).pdf

II

### 详图 II 1:2.5

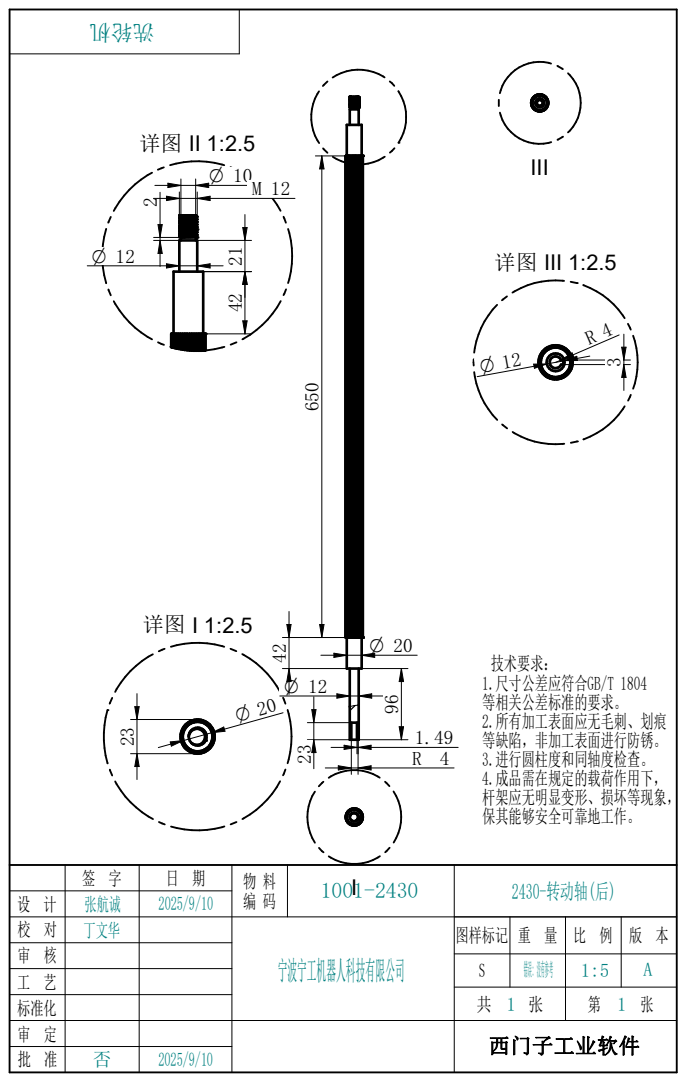
[picture p84: page 1]
技术要求：; 1.尺寸公差应符合GB/T 1804 等相关公差标准的要求。 2.所有加工表面应无毛刺、划痕 等缺陷，非加工表面进行防锈。 3.进行圆柱度和同轴度检查。 4.成品需在规定的载荷作用下， 杆架应无明显变形、损坏等现象， 保其能够安全可靠地工作。; III; 详图 III 1:2.5

设 计 | 签 字 | 日 期 | 物 料 编 码 | I 1001-2430 | 2430-转动轴(后)

张航诚 | 2025/9/10

校 对 | 丁文华 | | 宁波宁工机器人科技有限公司 | 图样标记 | 重 量 | 比 例 1:5 审 核 | 版 本

S | 错误: 没有参考 | | A

工 艺
标准化
审 定 | 否 | 2025/9/10 | 西门子工业软件
批 准
