cyx3705/2025-001/b-Module-2D/4350-橡胶垫片.pdf

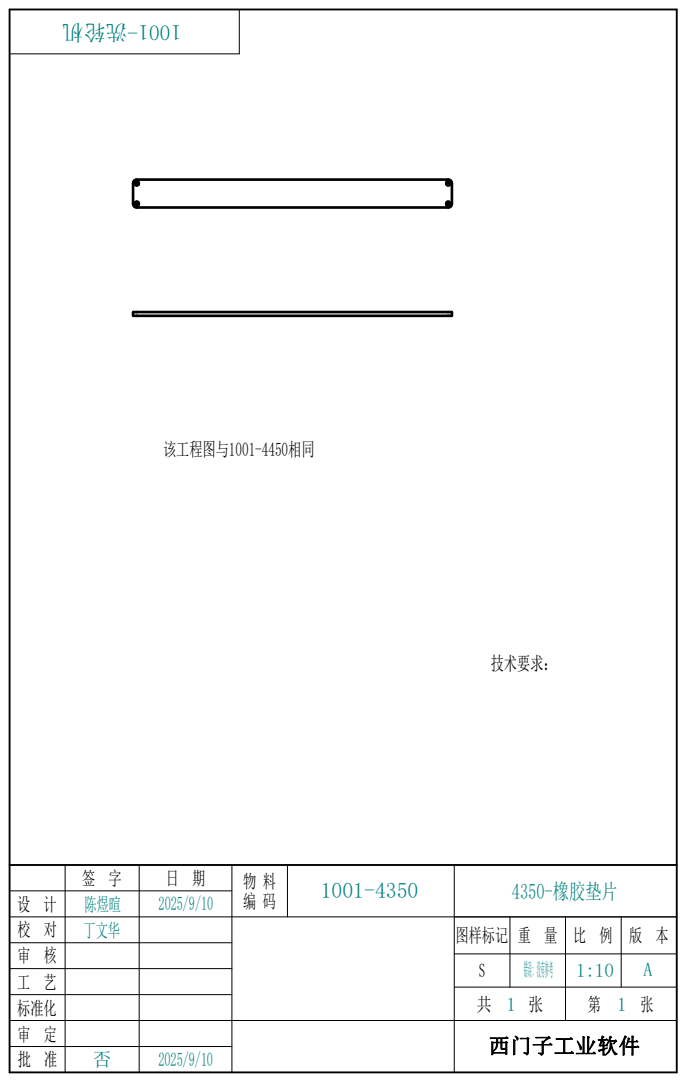
[picture p85: page 1]
技术要求：; 该工程图与1001-4450相同

设 计 | 签 字 | 日 期 | 物 料 编 码 | 1001-4350 | 4350-橡胶垫片

陈煜暄 | 2025/9/10

校 对 | 丁文华 | | | 图样标记 | 重 量 | 比 例 1:10 审 核 | 版 本

S | 错误: 没有参考 | | A
共 1 张 | | 第 1 张

工 艺
标准化
审 定 | 否 | 2025/9/10 | 西门子工业软件
批 准
