cyx3705/2025-001/b-Module-2D/4400-左托板.pdf

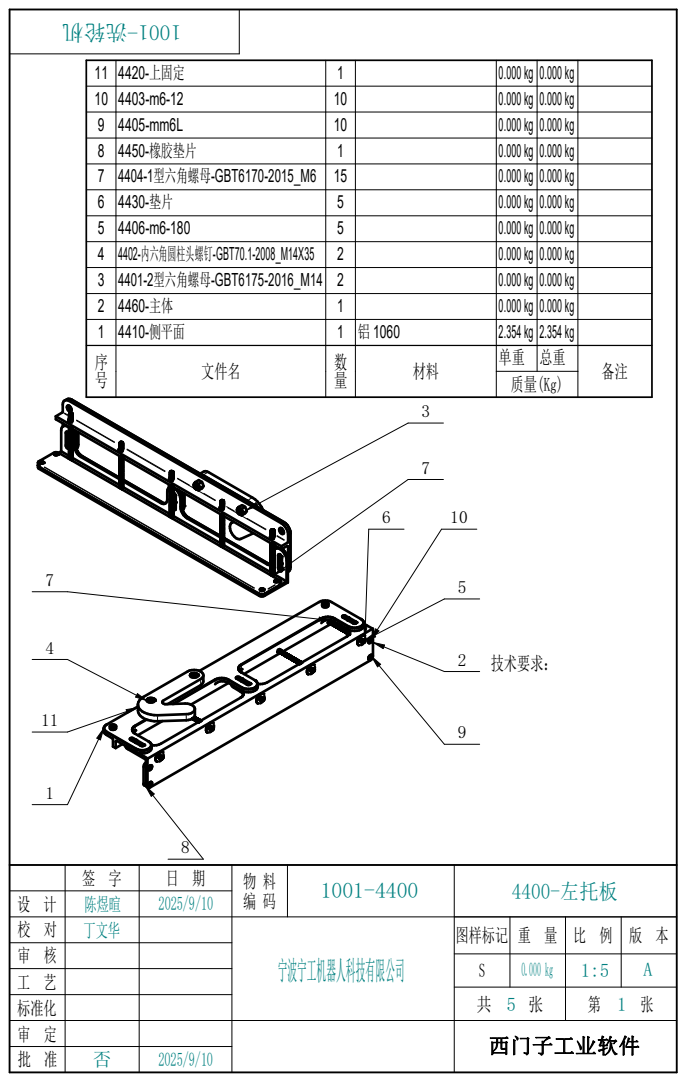
[picture p86: page 1]
技术要求：; 11 4420-上上定; 8 4450-橡橡橡橡; -GBT 型型型型型; -GBT70.1-2008_M14X35 内型型内内内型内; 1 4410-侧侧侧; 文件名

设 计 | 签 字 | 日 期 | 物 料 编 码 | 1001-4400 | 4400-左托板

陈煜暄 | 2025/9/10

校 对 | 丁文华 | | 宁波宁工机器人科技有限公司 | 图样标记 | 重 量 | 比 例 1:5 审 核 | 版 本

工 艺
标准化
审 定 | 否 | 2025/9/10 | 西门子工业软件
批 准
