cyx3705/2025-001/b-Module-2D/4420-上固定.pdf

### 剖剖 A-A

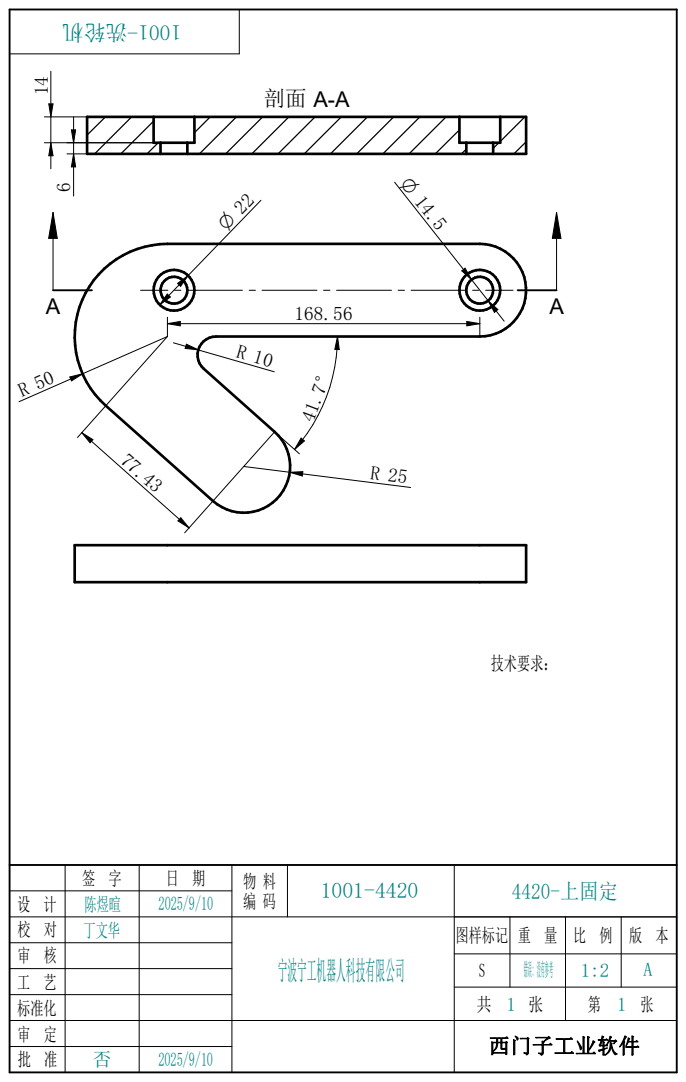
[picture p87: page 1]
技术要求：

设 计 | 签 字 | 日 期 | 物 料 编 码 | 1001-4420 | 4420-上固定

陈煜暄 | 2025/9/10

校 对 | 丁文华 | | 宁波宁工机器人科技有限公司 | 图样标记 | 重 量 | 比 例 1:2 审 核 | 版 本

S | 错误: 没有参考 | | A

工 艺
标准化
审 定 | 否 | 2025/9/10 | 西门子工业软件
批 准
