cyx3705/2025-001/b-Module-2D/4720-侧边架右下.pdf

### 剖剖 B-B

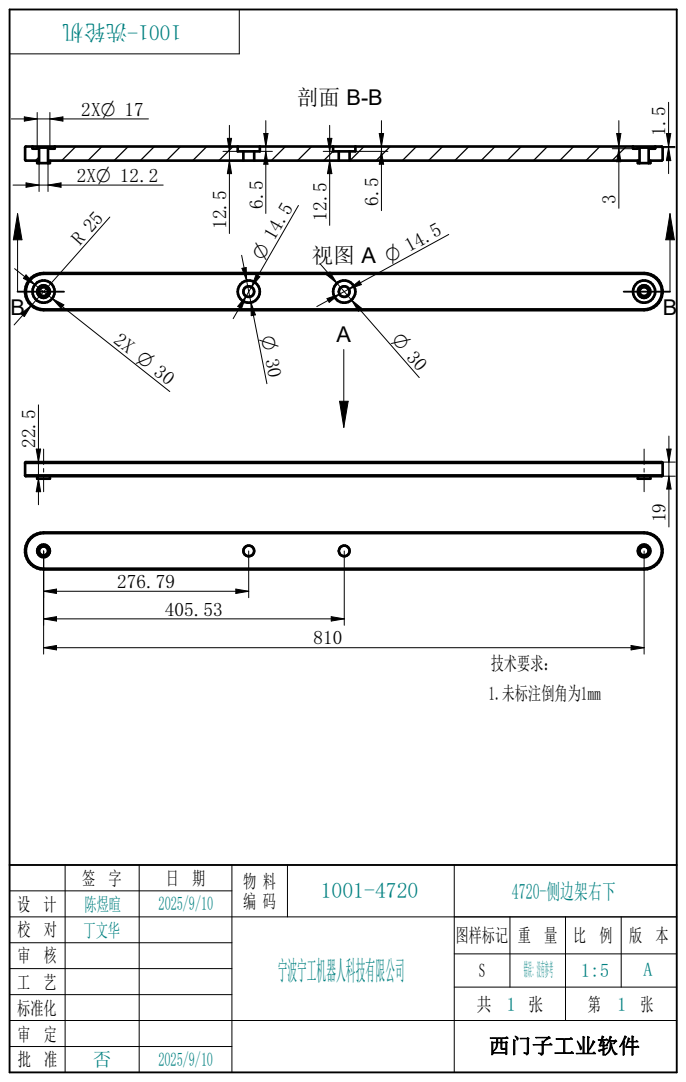
[picture p88: page 1]
技术要求：; 1.未标注倒角为1mm

设 计 | 签 字 | 日 期 | 物 料 编 码 | 1001-4720 | 4720-侧边架右下

陈煜暄 | 2025/9/10

校 对 | 丁文华 | | 宁波宁工机器人科技有限公司 | 图样标记 | 重 量 | 比 例 1:5 审 核 | 版 本

S | 错误: 没有参考 | | A

工 艺
标准化
审 定 | 否 | 2025/9/10 | 西门子工业软件
批 准
