cyx3705/2025-001/b-Module-2D/5000-电机.pdf

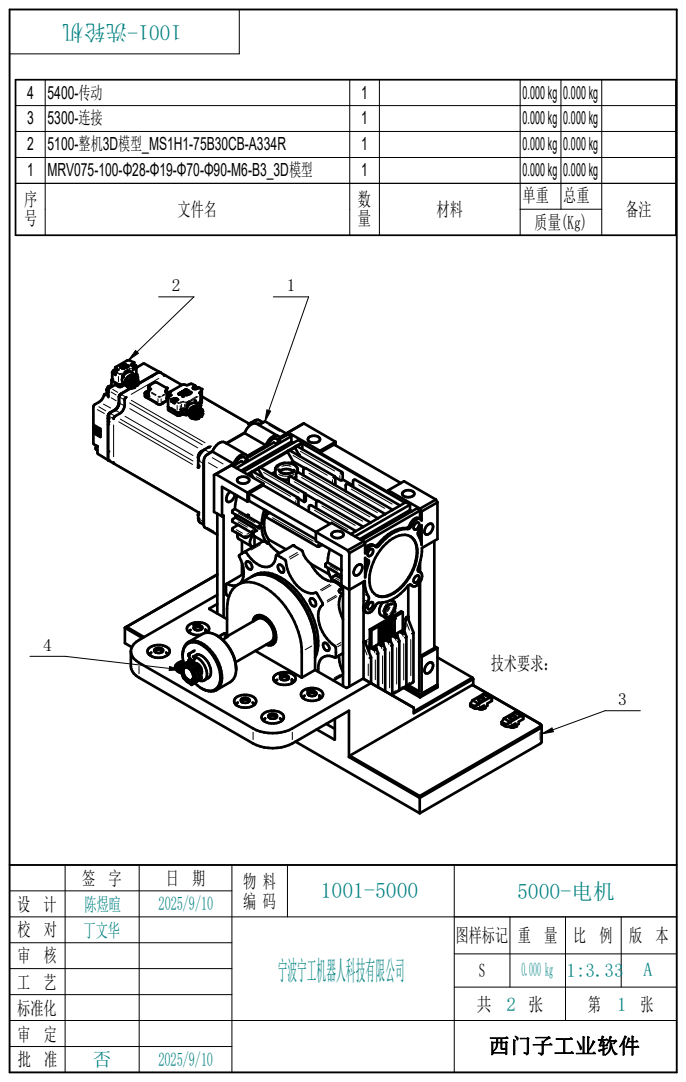
[picture p89: page 1]
技术要求：; 1 MRV075-100-Φ28-Φ19-Φ70-Φ90-M6-B3_3D模模; 文件名

陈煜暄 | 2025/9/10

校 对 | 丁文华 | | 宁波宁工机器人科技有限公司 | 图样标记 | 重 量 | 比 例 1:3.33 审 核 | 版 本

工 艺
标准化
审 定 | 否 | 2025/9/10 | 西门子工业软件
批 准
