cyx3705/2025-001/(commit log)

2026-08-12 一键推送更新
2026-08-14 chore: 迁移到 HistoryClio 后的工作区基线
    分仓库迁移遗留在工作区的改动一次性落库，并清理模板带下来的 Unused 脚手架。
    - 其余为迁移过程产生的工作区差异，未逐条审阅业务含义。
    本次由 Claude 代为提交，用于把分仓库后的工作树归零。
    [0-装配体.SLDASM, 0000-0504.cfg, 0000-0507.cfg, 0000-0508.cfg, 0000-0509.cfg, 0000-0511-DESKTOP-9UM5LFH.cfg, 0000-0511.cfg, 0000-0512-LAPTOP-TETJB8Q4.cfg]
2026-08-17 对齐 LFS 指针规则：246 条扩展名通配 -> 117 条精确路径
    按扩展名批量套 LFS 是 11GB 占用与推送被拒的根因。现存指针逐条保留以免失效；
    新文件不再自动进 LFS，只有超过 GitHub 100MB 硬限时才由提交链路逐个征求同意。
2026-09-21 LFS 修复：117 个不足 100MB 的文件转回普通入库（第 1/1 批）
    [0-装配体.SLDASM, BOM表.xlsx, _model1.prt, 净水器装配.IGS, 工程图.dwg, 电气BOM表.xlsx, 零件.SLDPRT, 零件1_par.prt]
2026-10-23 README：保留内容对齐模板（logo与作者）
    Claude-Session: https://claude.ai/code/session_01UZ5WhpwWxzS9khp6UQSn2P
